JovanyZepeda/Baja-CPP-Power-Module/LT3579-SEPIC-EAGLE-Project/Custom or imported Eagle Libraries/SDT5H100SB-13.stp

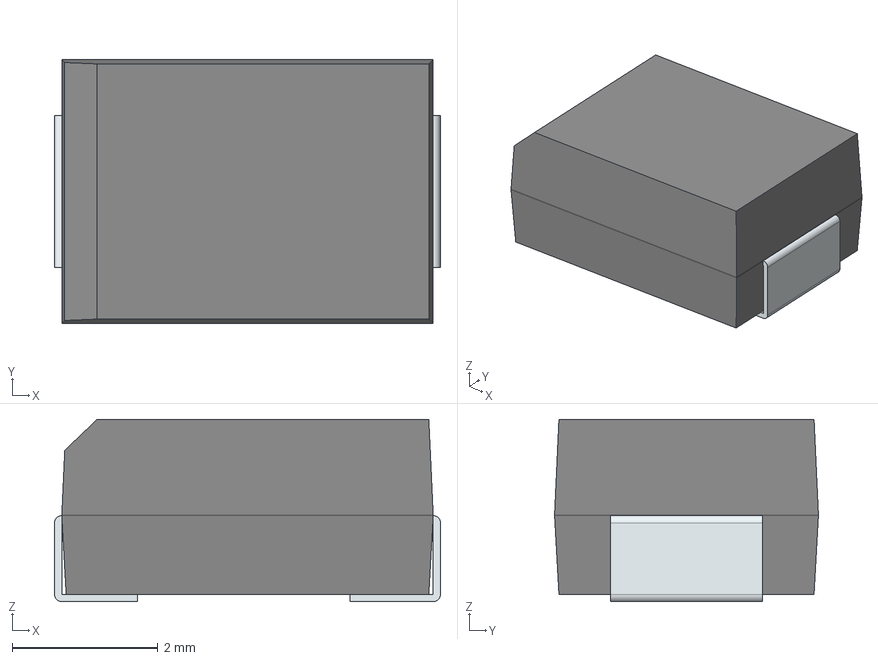
[picture p1: CAD file, 2022-03-18]
LT3579-SEPIC-EAGLE-Project/Custom or imported Eagle Libraries/SDT5H100SB-13.stp
5.29 x 3.62 x 2.50 mm
FilletPin1
FilletPin2
