JovanyZepeda/Baja-CPP-Power-Module/(list of files, cad)

Other CAD files:
LT3579-SEPIC-EAGLE-Project/Custom or imported Eagle Libraries/SDT5H100SB-13.stl
