JovanyZepeda/Baja-CPP-Power-Module/LT3579-SEPIC-EAGLE-Project/LT3579_SEPIC_Test_Bench.pdf

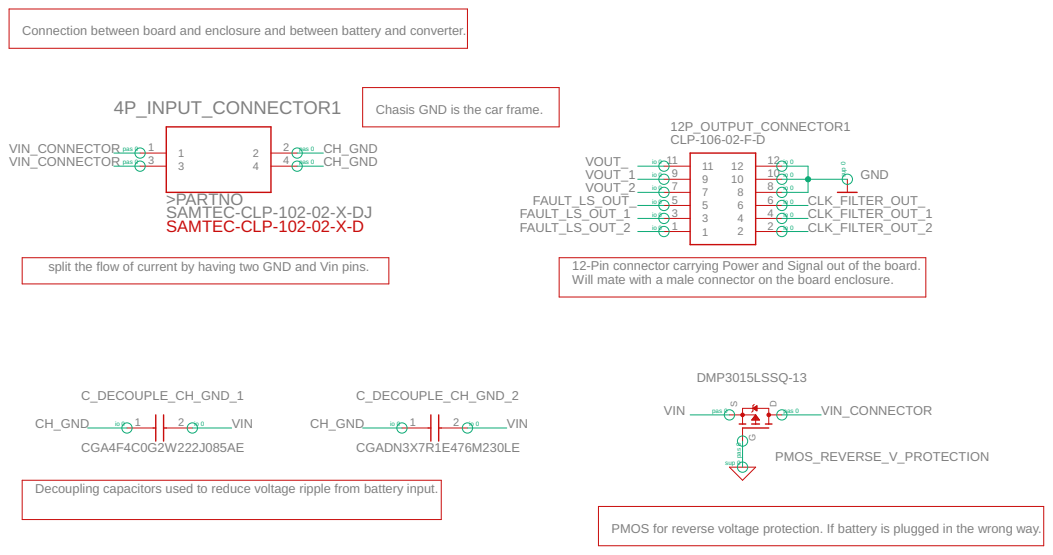
[picture p2: page 1]

Connection between board and enclosure and between battery and converter.

Chasis GND is the car frame.

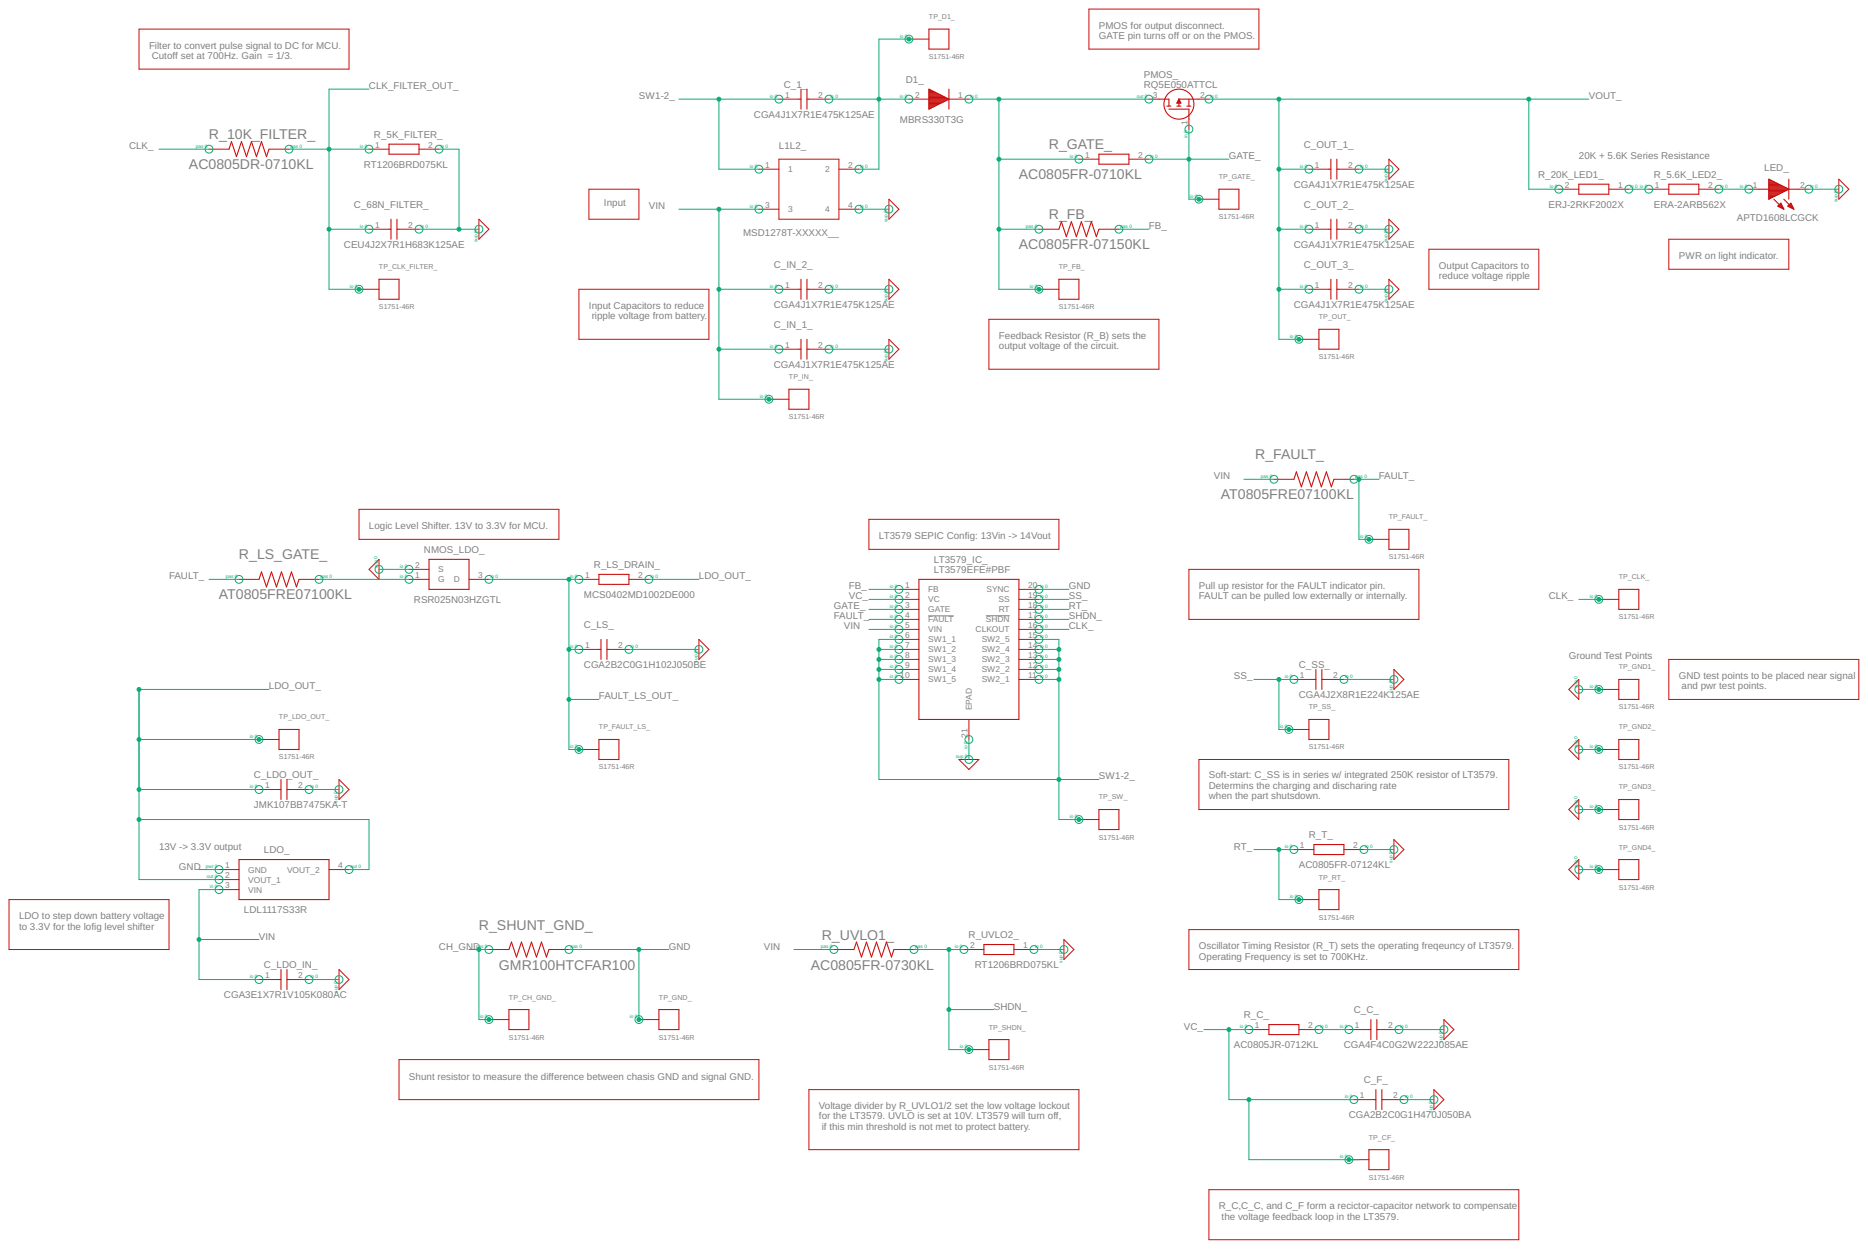
[picture p3: page 2]

PMOS for output disconnect. GATE pin turns off or on the PMOS.

Filter to convert pulse signal to DC for MCU. Cutoff set at 700Hz. Gain = 1/3.

PWR on light indicator.

Input Capacitors to reduce

Feedback Resistor (R_B) sets the
output voltage of the circuit.

Logic Level Shifter. 13V to 3.3V for MCU.

Pull up resistor for the FAULT indicator pin. FAULT can be pulled low externally or internally.

up 0 sup 0 sup 0 sup 0

GND test points to be placed near signal and pwr test points.

Soft-start: C_SS is in series w/ integrated 250K resistor of LT3579. Determins the charging and discharing rate when the part shutsdown.

LDO to step down battery voltage
to 3.3V for the lofig level shifter

Oscillator Timing Resistor (R_T) sets the operating freqeuncy of LT3579. Operating Frequency is set to 700KHz.

Shunt resistor to measure the difference between chasis GND and signal GND.

Voltage divider by R_UVLO1/2 set the low voltage lockout
for the LT3579. UVLO is set at 10V. LT3579 will turn off,
if this min threshold is not met to protect battery.

R_C,C_C, and C_F form a recictor-capacitor network to compensate
the voltage feedback loop in the LT3579.

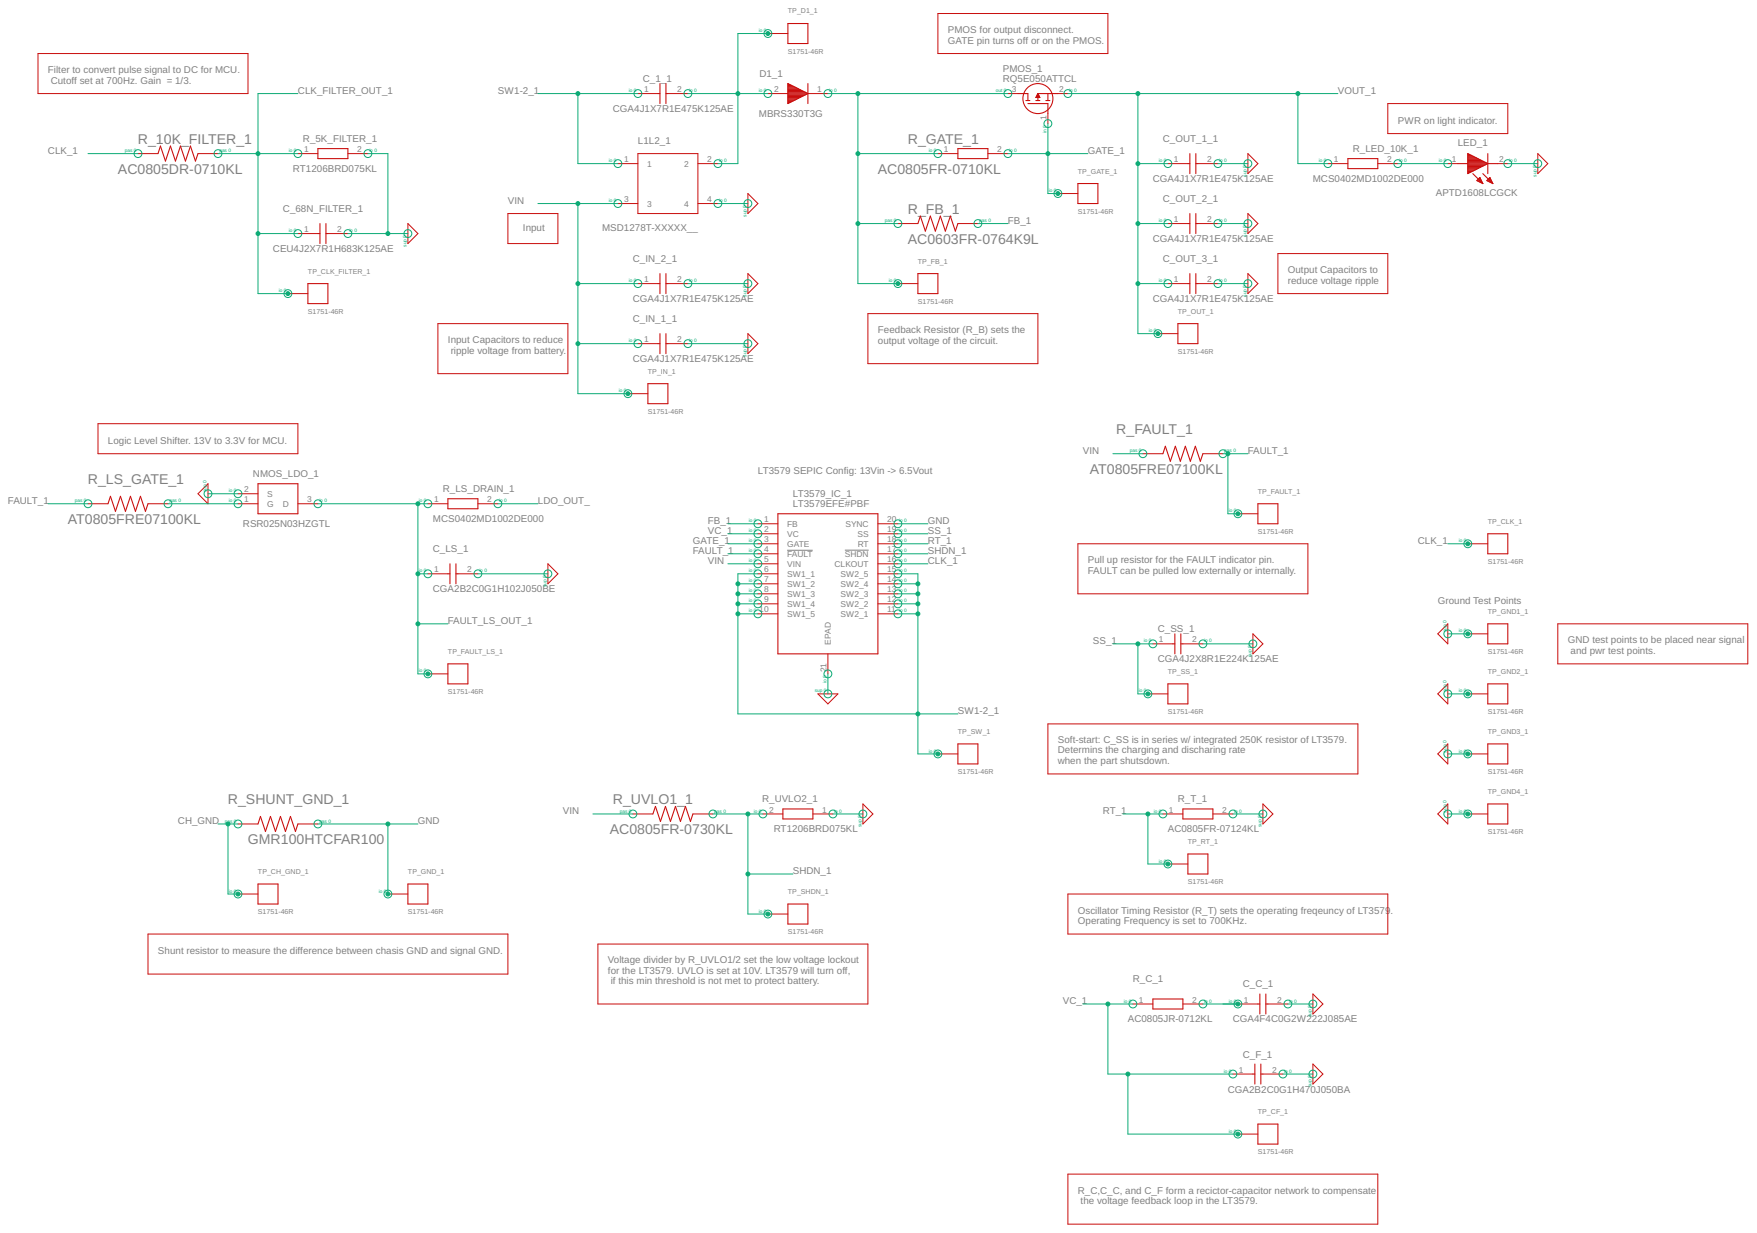
[picture p4: page 3]

Filter to convert pulse signal to DC for MCU. Cutoff set at 700Hz. Gain = 1/3.

PWR on light indicator.

reduce voltage ripple Feedback Resistor (R_B) sets the

Input Capacitors to reduce
ripple voltage from battery.

output voltage of the circuit.

Logic Level Shifter. 13V to 3.3V for MCU.

Pull up resistor for the FAULT indicator pin. FAULT can be pulled low externally or internally.

up 0 sup 0 sup 0 sup 0

GND test points to be placed near signal and pwr test points.

Soft-start: C_SS is in series w/ integrated 250K resistor of LT3579. Determins the charging and discharing rate when the part shutsdown.

Oscillator Timing Resistor (R_T) sets the operating freqeuncy of LT3579. Operating Frequency is set to 700KHz.

Shunt resistor to measure the difference between chasis GND and signal GND.

Voltage divider by R_UVLO1/2 set the low voltage lockout
for the LT3579. UVLO is set at 10V. LT3579 will turn off,
if this min threshold is not met to protect battery.

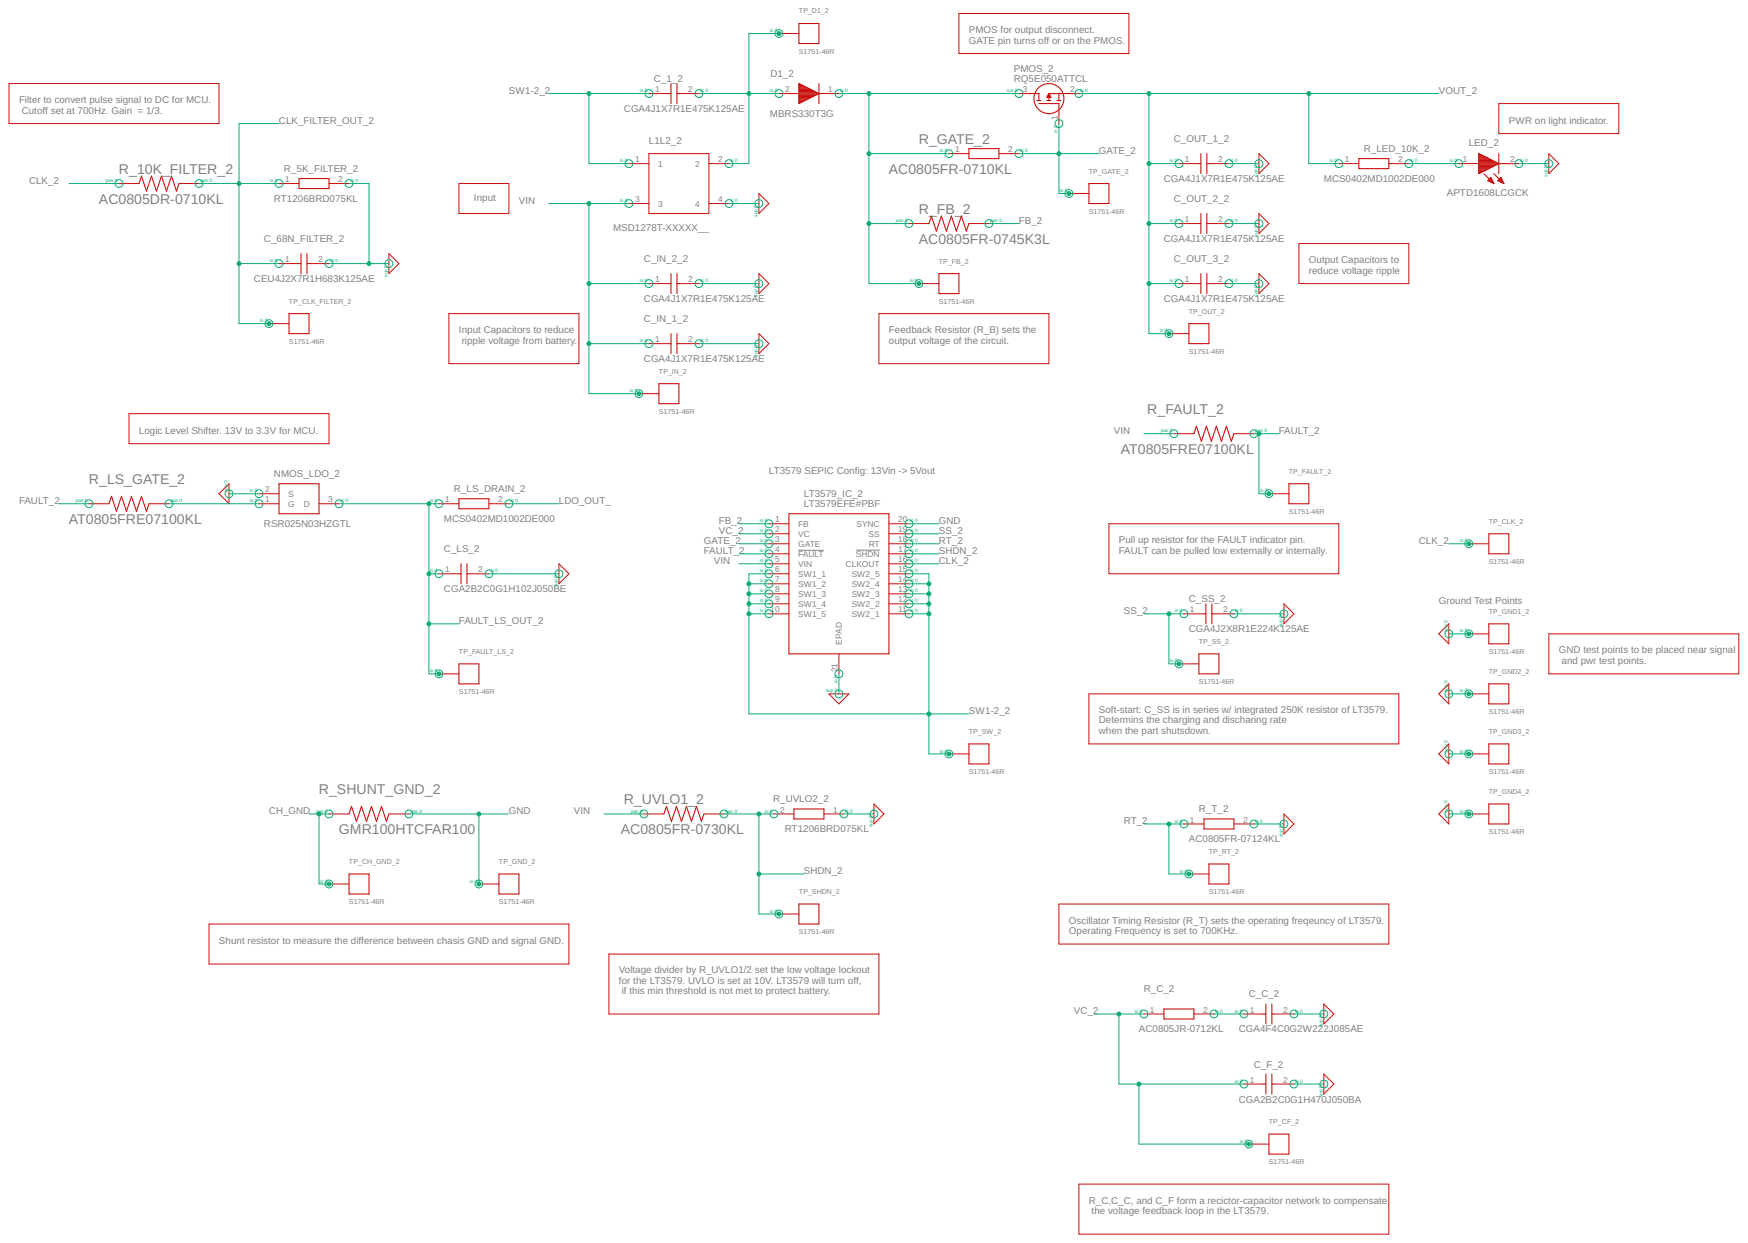
[picture p5: page 4]

Filter to convert pulse signal to DC for MCU. Cutoff set at 700Hz. Gain = 1/3.

PWR on light indicator.

reduce voltage ripple Feedback Resistor (R_B) sets the

Input Capacitors to reduce
ripple voltage from battery.

output voltage of the circuit.

Logic Level Shifter. 13V to 3.3V for MCU.

Pull up resistor for the FAULT indicator pin. FAULT can be pulled low externally or internally.

up 0 sup 0 sup 0 sup 0

GND test points to be placed near signal and pwr test points.

Soft-start: C_SS is in series w/ integrated 250K resistor of LT3579. Determins the charging and discharing rate when the part shutsdown.

Oscillator Timing Resistor (R_T) sets the operating freqeuncy of LT3579. Operating Frequency is set to 700KHz.

Shunt resistor to measure the difference between chasis GND and signal GND.

Voltage divider by R_UVLO1/2 set the low voltage lockout
for the LT3579. UVLO is set at 10V. LT3579 will turn off,
if this min threshold is not met to protect battery.
