JovanyZepeda/Baja-CPP-Power-Module/LT3579-SEPIC-13Vin_14Vout/LT3579_SEPIC_0009.asc

C1: cap; 4.7µ; V=35 Rser=0.001
C_c: cap; 2.2n; V=50
C_F: cap; 47p; V=25
C_IN: cap; 4.7µ; x2; V=35 Irms=0 Rser=0.001 Lser=0
C_OUT: cap; 4.7µ; x3; V=35 Irms=0 Rser=0.001 Lser=0
C_SS: cap; 0.02µ; V=50
D1: schottky
D2: schottky
L1: ind2; 8.2µ; Ipk=10 Rser=55m
L2: ind2; 8.2µ; Ipk=10 Rser=55m
M1: pmos
R1: res; 6.5k
R_c: res; 7.5k; tol=1
R_FAULT: res; 100k; tol=1
R_FB: res; 153k; tol=1
R_LOAD: res; 14
R_T: res; 124k; tol=1
R_UVLO1: res; 13k; tol=1
R_UVLO2: res; 5k; tol=0.1
U1: LT3579
V_Battery: voltage; 13
Named nets: 0, IN, OUT, SS, Vc, SW1/2, FT, SHDN, GATE, FB, DRAIN
K1 L1 L2 1
.tran 0 2ms 0 0.001 startup
Note: C_SS is actually 0.22u  but has been changed to 0.022u  so that the rise time is smaller. Increases speed of simulation.
13V
0A
700 khz
Compensator Circuit
.step param R_LOAD 1 30 1
