JovanyZepeda/Baja-CPP-Power-Module/LT3579-CLK-Filter/LT3579_SEPIC_CLK_Filter_01.asc

C1: cap; 68.2n
R1: res; 10k
R2: res; 5k
V1: voltage; PULSE(0 3 0 12n 8n {t_ON} 1.428u)
Named nets: 0
.tran 0 10m 0 0.01
.step param t_ON 0.28571u 0.999u 0.05u
Test filter from MATLAB code. Filter out the higher harmonics of pulse and keep the DC componant for MCU to read.
F_c = 700 Hz, Gain = 1/3
