JovanyZepeda/Baja-CPP-Power-Module/LT3579-SEPIC-13Vin_5Vout/LT3579_SEPIC_13Vin_5Vout_01.asc

C1: cap; 4.7µ; V=25 Rser=0.01
C_c: cap; 2.2n; V=450
C_F: cap; 47p; V=50
C_IN: cap; 4.7; x2; V=25 Irms=0 Rser=0.01 Lser=0
C_OUT: cap; 4.7µ; x3; V=25 Irms=0 Rser=0.01 Lser=0 Rpar=0
C_SS: cap; 0.022µ; V=25
D1: schottky; MBRS360
L1: ind2; 8.2µ; Ipk=10 Rser=55m
L2: ind2; 8.2µ; Ipk=10 Rser=55m
R_c: res; 12k; tol=5
R_FAULT: res; 100k; tol=1
R_FB: res; 45.3k; tol=1
R_GATE: res; 10k
R_LOAD: res; 5
R_T: res; 124k; tol=5
R_UVLO1: res; 30k; tol=1
R_UVLO2: res; 5k; tol=0.1
U1: LT3579
U2: RQ5E050AT
V_Battery: voltage; 13; Rser=0.4
Named nets: 0, IN, SOURCE, SS, Vc, SW1/2, FT, SHDN, GATE, FB, DRAIN, Vbattery
K1 L1 L2 0.98
Note: C_SS is actually 0.22u  but has been changed to 0.022u  so that the rise time is smaller. Increases speed of simulation.
0A
700 khz
Compensator Circuit
100k Potentiometer = R_c for testing board
.tran 0 2ms 0
MSD1278T Coupling Coefficient = 0.98
13Vin -> 5Vout SEPIC
