JovanyZepeda/Baja-CPP-Power-Module/LT3579-SEPIC-13Vin_14Vout/LT3579_SEPIC_MC1.asc

C1: cap; {mc(4.7u,0.1)}; V=25 Rser=0.01
C_c: cap; {mc(2.2n,0.5)}; V=450
C_F: cap; {mc(47p,0.05)}; V=50
C_IN: cap; {mc(4.7u,0.1)}; x2; V=25 Irms=0 Rser=0.01 Lser=0
C_OUT: cap; {mc(4.7u,0.1)}; x3; V=25 Irms=0 Rser=0.01 Lser=0 Rpar=0
C_SS: cap; 0.022µ; V=25
D1: schottky; MBRS360
L1: ind2; {mc(8.2u,0.2)}; Ipk=10 Rser=55m
L2: ind2; {mc(8.2u,0.2)}; Ipk=10 Rser=55m
R_c: res; {mc(12k,0.5)}; tol=5
R_FAULT: res; {mc(100k,0.01)}; tol=1
R_FB: res; {mc(150k,0.01)}; tol=1
R_GATE: res; {mc(10k,0.005)}
R_LOAD: res; {mc(18,0.2)}
R_T: res; {mc(124k,0.05)}; tol=5
R_UVLO1: res; {mc(30k,0.01)}; tol=1
R_UVLO2: res; {mc(5k,0.01)}; tol=0.1
U1: LT3579
U2: RQ5E050AT
V_Battery: voltage; {mc(13,0.25)}; Rser=0.4
Named nets: 0, IN, SOURCE, SS, Vc, SW1/2, FT, SHDN, GATE, FB, DRAIN
K1 L1 L2 0.98
Note: C_SS is actually 0.22u  but has been changed to 0.022u  so that the rise time is smaller. Increases speed of simulation.
0A
700 khz
Compensator Circuit
100k Potentiometer = R_c for testing board
.tran 0 2ms 1.8ms startup
MSD1278T Coupling Coefficient = 0.98
Monte Carlo Simulation Test
.step param X 1 100 1
Monte carlo sim is set so that 100 trials are run, each for 2ms.
w/ Varying Input Voltage
