JovanyZepeda/Baja-CPP-Power-Module/LT3579-SEPIC-13Vin_14Vout/LT3579_SEPIC_0003.asc

C1: cap; 4.7µ
C_c: cap; 2.2n
C_F: cap; 47p
C_IN: cap; 4.7
C_OUT: cap; 10µ; V=25 Irms=0 Rser=0.001 Lser=0
C_SS: cap; 0.022µ
D1: schottky; PDS5100
L1: ind2; 8.2µ
L2: ind2; 8.2µ
R_c: res; 10k
R_FAULT: res; 100k
R_FB: res; 153k
R_LOAD: res; 14
R_T: res; 124k
R_UVLO1: res; 13k
R_UVLO2: res; 5k
U1: LT3579
V_Battery: voltage; 13
Named nets: 0, IN, OUT, SS, Vc, SW1/2, FT, SHDN
K1 L1 L2 1
.tran 0 2m 1m startup
Note: C_SS is actually 0.22u  but has been changed to 0.022u  so that the rise time is smaller. Increases speed of simulation.
Cout: Three parallel capacitors 
for a total capacitance of 27.41u
