JovanyZepeda/Baja-CPP-Power-Module/LT3579-SEPIC-13Vin_14Vout/LT3579_SEPIC_0001.asc

C1: cap; 4.7µ
C_c: cap; 2.2n
C_F: cap; 47p
C_IN: cap; 5.08µ
C_OUT_1: cap; 27.41µ
C_OUT_2: cap; 27.41µ
C_OUT_3: cap; 27.41µ
C_SS: cap; 1n
D1: schottky
L1: ind2; 8µ
L2: ind2; 8µ
R_c: res; 10k
R_FAULT: res; 100k
R_FB: res; 153.48k
R_LOAD: res; 14
R_T: res; 124.14
R_UVLO1: res; 13.22k
R_UVLO2: res; 5k
U1: LT3579
V_Battery: voltage; 13
Named nets: 0, IN, OUT, SS, SHDN, Vc, SW1/2, FT
K L1 L2 1
.tran  2m  startup
Note: C_SS is actually 100n but has been changed to 1n so that the rise time is smaller. Increases speed of simulation.
