JovanyZepeda/Baja-CPP-Power-Module/LT3579-SEPIC-EAGLE-Project/LT3579_SEPIC_Test_Bench.brd

## EAGLE design LT3579-SEPIC-EAGLE-Project/LT3579_SEPIC_Test_Bench.brd (2022-04-27)

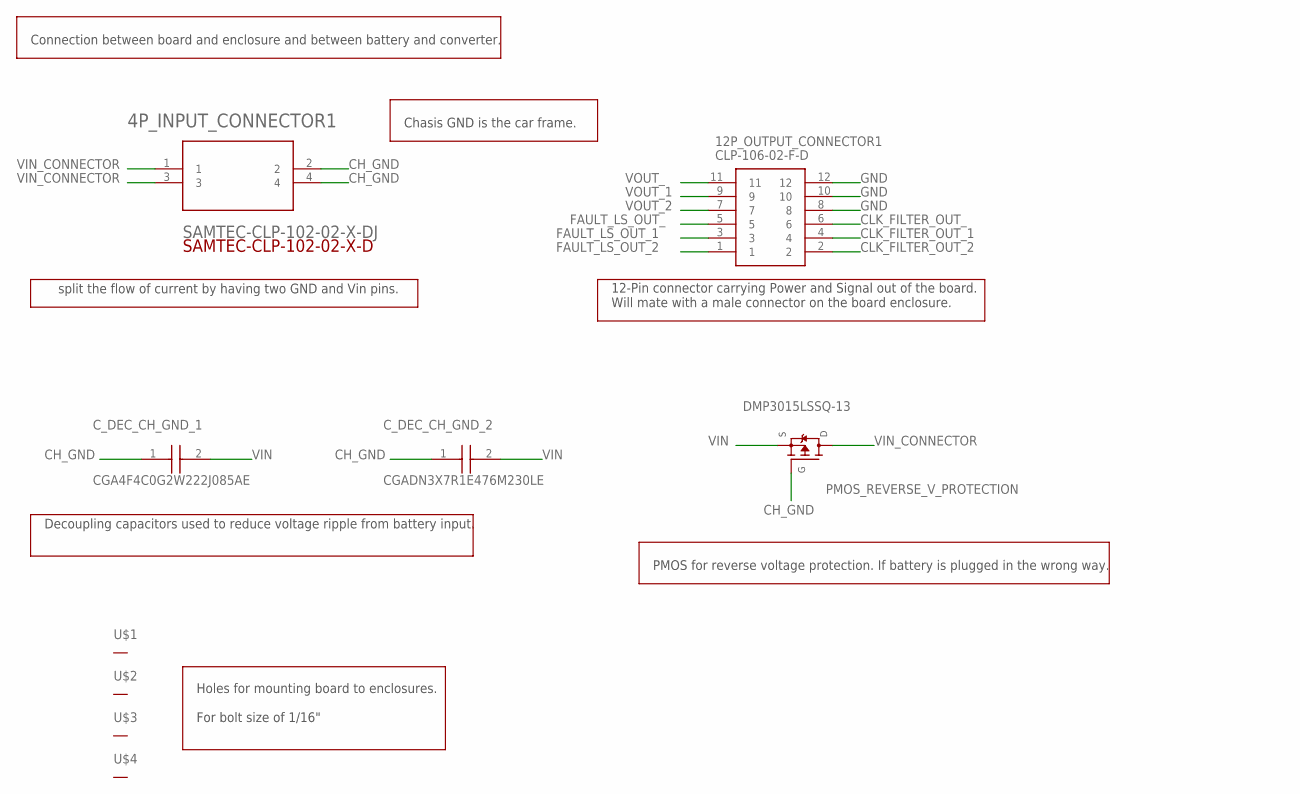
[picture p6: schematic LT3579_SEPIC_Test_Bench.sch, sheet 1]

Parts:
4P_INPUT_CONNECTOR1: SAMTEC-CLP-102-02-X-DJ; SAMTEC-CLP-102-02-X-D
12P_OUTPUT_CONNECTOR1: CLP-106-02-F-D; CLP-106-02-XXX
C_DEC_CH_GND_1: CGA4F4C0G2W222J085AE; CAPC2012X100N
C_DEC_CH_GND_2: CGADN3X7R1E476M230LE; CAPC7563X250N
PMOS_REVERSE_V_PROTECTION: DMP3015LSSQ-13; SOIC127P600X170-8N
U$1, U$2, U$3, U$4: THROUGH_HOLE_; THROUGH_HOLE

Connections:
CH_GND: 4P_INPUT_CONNECTOR1.2, 4P_INPUT_CONNECTOR1.4, C_DEC_CH_GND_1.1, C_DEC_CH_GND_2.1, PMOS_REVERSE_V_PROTECTION.4 (G1); also elsewhere on the board
CLK_FILTER_OUT_: 12P_OUTPUT_CONNECTOR1.6; also elsewhere on the board
CLK_FILTER_OUT_1: 12P_OUTPUT_CONNECTOR1.4; also elsewhere on the board
CLK_FILTER_OUT_2: 12P_OUTPUT_CONNECTOR1.2; also elsewhere on the board
FAULT_LS_OUT_: 12P_OUTPUT_CONNECTOR1.5; also elsewhere on the board
FAULT_LS_OUT_1: 12P_OUTPUT_CONNECTOR1.3; also elsewhere on the board
FAULT_LS_OUT_2: 12P_OUTPUT_CONNECTOR1.1; also elsewhere on the board
GND: 12P_OUTPUT_CONNECTOR1.8, 12P_OUTPUT_CONNECTOR1.10, 12P_OUTPUT_CONNECTOR1.12; also elsewhere on the board
VIN: C_DEC_CH_GND_1.2, C_DEC_CH_GND_2.2, PMOS_REVERSE_V_PROTECTION.1 (S1), PMOS_REVERSE_V_PROTECTION.2 (S1), PMOS_REVERSE_V_PROTECTION.3 (S1); also elsewhere on the board
VIN_CONNECTOR: 4P_INPUT_CONNECTOR1.1, 4P_INPUT_CONNECTOR1.3, PMOS_REVERSE_V_PROTECTION.5 (D1), PMOS_REVERSE_V_PROTECTION.6 (D1), PMOS_REVERSE_V_PROTECTION.7 (D1), PMOS_REVERSE_V_PROTECTION.8 (D1)
VOUT_: 12P_OUTPUT_CONNECTOR1.11; also elsewhere on the board
VOUT_1: 12P_OUTPUT_CONNECTOR1.9; also elsewhere on the board
VOUT_2: 12P_OUTPUT_CONNECTOR1.7; also elsewhere on the board

Notes on the sheet:
Connection between board and enclosure and between battery and converter.
split the flow of current by having two GND and Vin pins.
12-Pin connector carrying Power and Signal out of the board. Will mate with a male connector on the board enclosure.
Decoupling capacitors used to reduce voltage ripple from battery input.
PMOS for reverse voltage protection. If battery is plugged in the wrong way.
Chasis GND is the car frame.
Holes for mounting board to enclosures. For bolt size of 1/16"

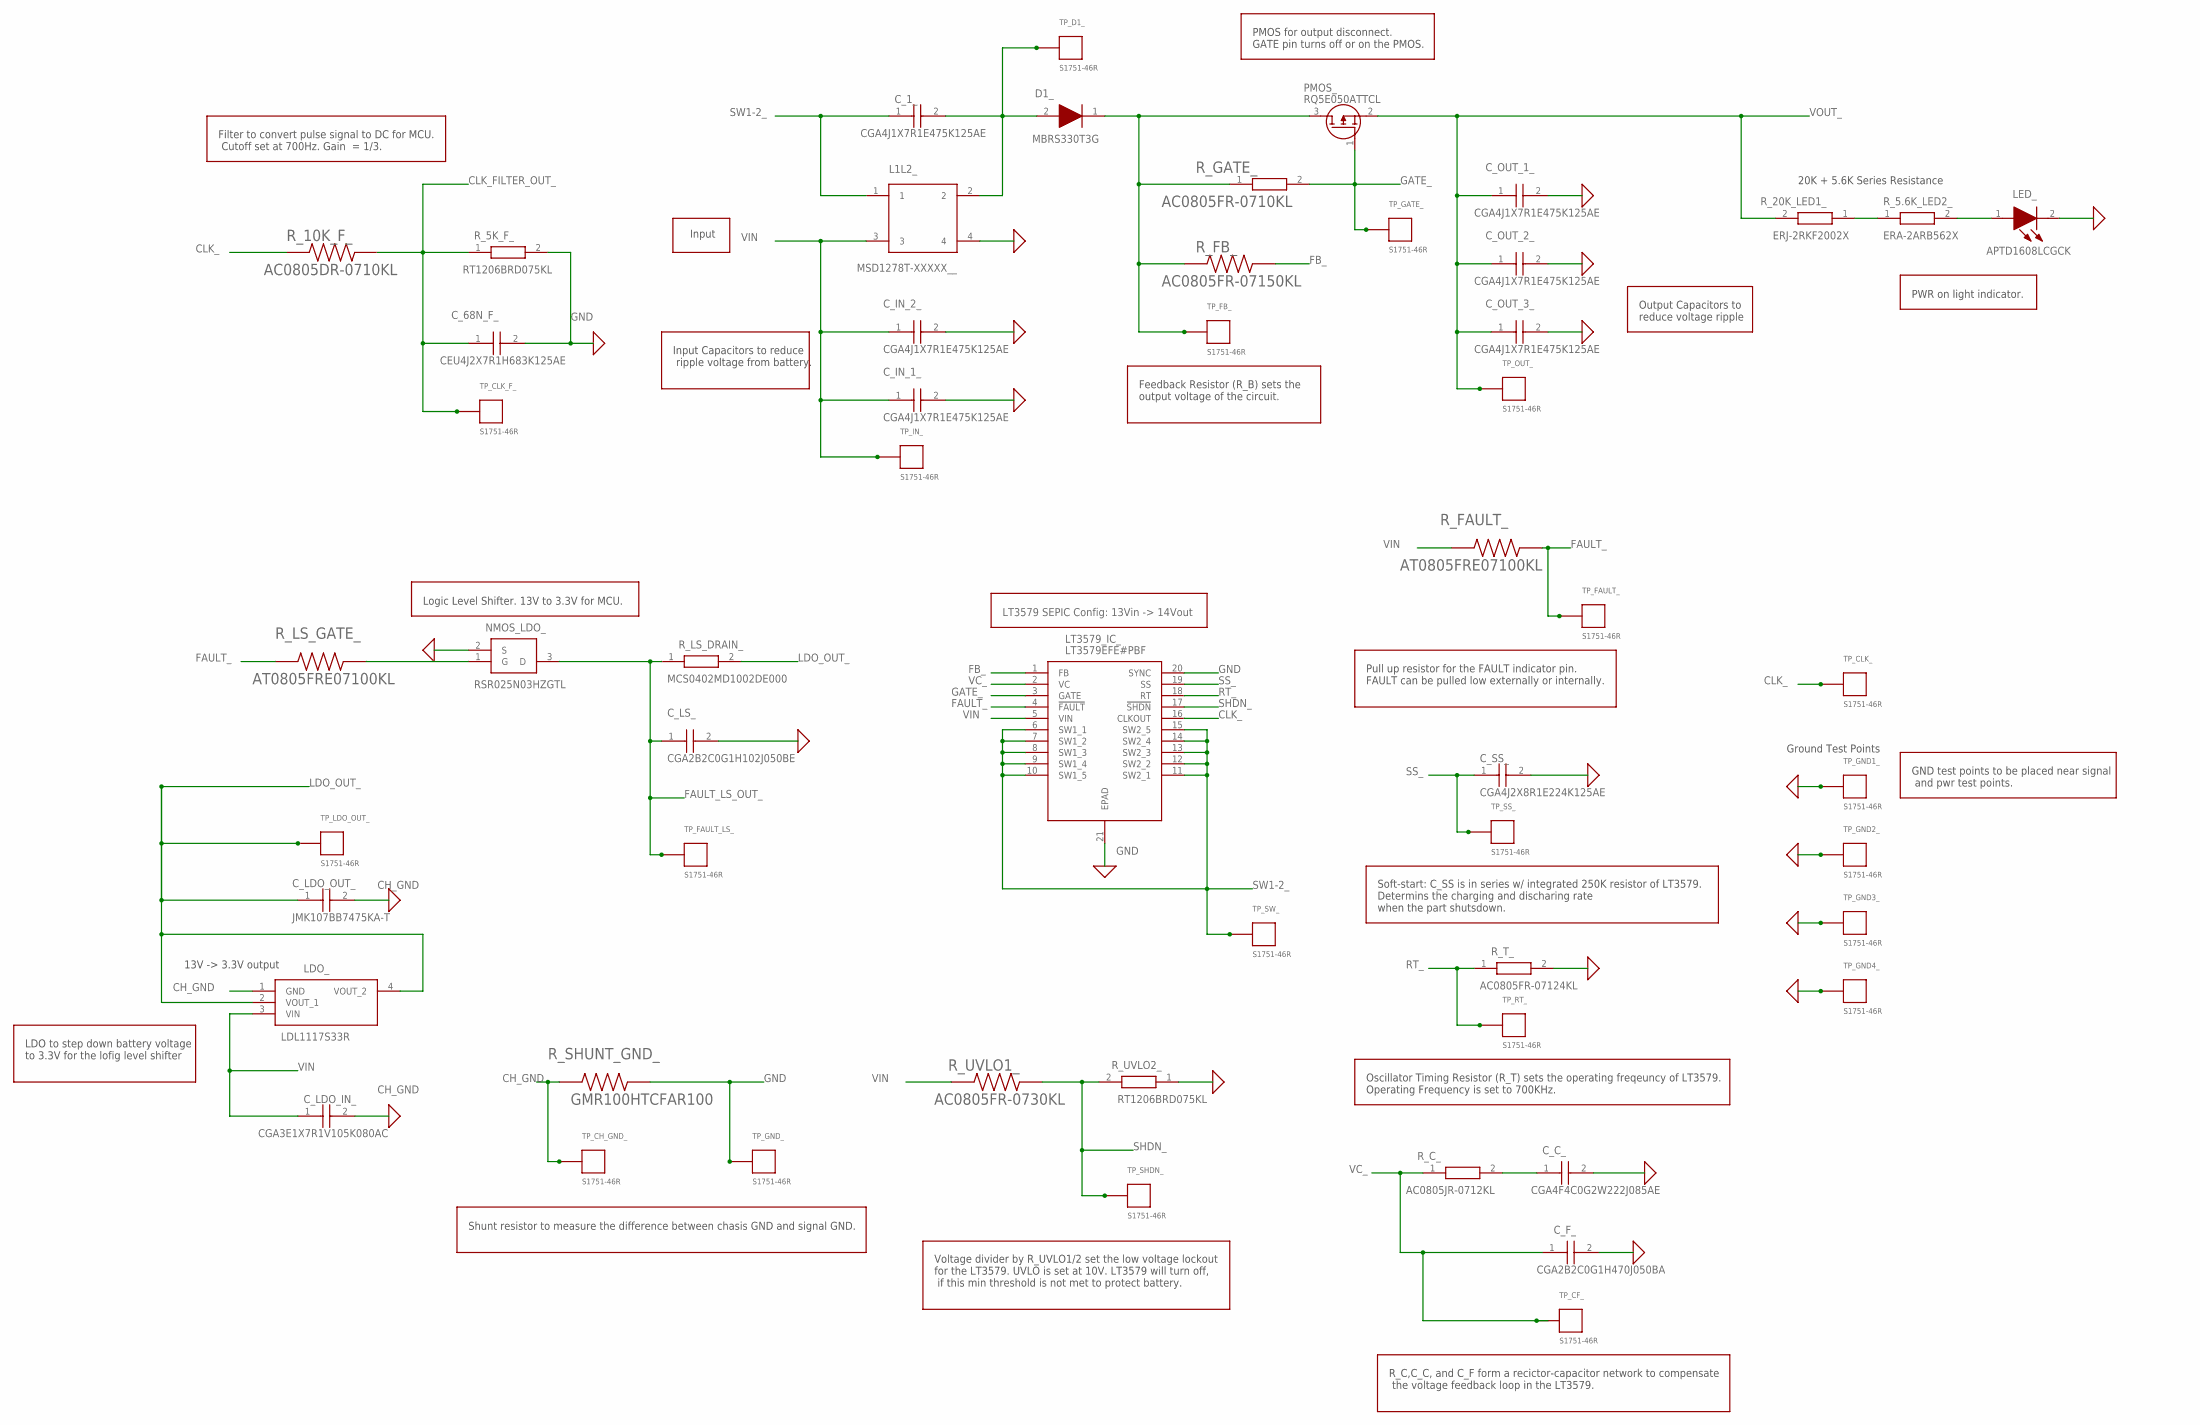
[picture p7: schematic LT3579_SEPIC_Test_Bench.sch, sheet 2]

Parts:
C_1_: CGA4J1X7R1E475K125AE; CAPC2012X145N
C_68N_F_: CEU4J2X7R1H683K125AE; CAPC2013X150N
C_C_: CGA4F4C0G2W222J085AE; CAPC2012X100N
C_F_: CGA2B2C0G1H470J050BA; CAPC1005X55N
C_IN_1_, C_IN_2_: CGA4J1X7R1E475K125AE; CAPC2012X145N
C_LDO_IN_: CGA3E1X7R1V105K080AC; CAPC1608X90N
C_LDO_OUT_: JMK107BB7475KA-T; CAPC1608X90N
C_LS_: CGA2B2C0G1H102J050BE; CAPC1005X55N
C_OUT_1_, C_OUT_2_, C_OUT_3_: CGA4J1X7R1E475K125AE; CAPC2012X145N
C_SS_: CGA4J2X8R1E224K125AE; CAPC2012X145N
D1_: MBRS330T3G; DIOM7958X256N
L1L2_: MSD1278T-XXXXX__; MSD1278T-822MLXX
LDO_: LDL1117S33R; SOT230P700X180-4N
LED_: APTD1608LCGCK; APT1608CGCK
LT3579_IC_: LT3579EFE#PBF; SOP65P640X120-21N
NMOS_LDO_: RSR025N03HZGTL; SOT95P280X100-3N
PMOS_: RQ5E050ATTCL; SOT95P280X100-3N
R_5.6K_LED2_: ERA-2ARB562X; ERA2AED122X
R_5K_F_: RT1206BRD075KL; RESC3116X65N
R_10K_F_: AC0805DR-0710KL; RESC2012X60N
R_20K_LED1_: ERJ-2RKF2002X; ERJ2R_(0402)
R_C_: AC0805JR-0712KL; RESC2012X60N
R_FAULT_: AT0805FRE07100KL; RESC2012X60N
R_FB_: AC0805FR-07150KL; RESC2012X60N
R_GATE_: AC0805FR-0710KL; RESC2012X60N
R_LS_DRAIN_: MCS0402MD1002DE000; RESC1005X37N
R_LS_GATE_: AT0805FRE07100KL; RESC2012X60N
R_SHUNT_GND_: GMR100HTCFAR100; RESC6432X55N
R_T_: AC0805FR-07124KL; RESC2012X60N
R_UVLO1_: AC0805FR-0730KL; RESC2012X60N
R_UVLO2_: RT1206BRD075KL; RESC3116X65N
TP_CF_: S1751-46R; S1751-46R_
TP_CH_GND_: S1751-46R; S1751-46R_
TP_CLK_: S1751-46R; S1751-46R_
TP_CLK_F_: S1751-46R; S1751-46R_
TP_D1_: S1751-46R; S1751-46R_
TP_FAULT_: S1751-46R; S1751-46R_
TP_FAULT_LS_: S1751-46R; S1751-46R_
TP_FB_: S1751-46R; S1751-46R_
TP_GATE_: S1751-46R; S1751-46R_
TP_GND1_, TP_GND2_, TP_GND3_, TP_GND4_: S1751-46R; S1751-46R_
TP_GND_: S1751-46R; S1751-46R_
TP_IN_: S1751-46R; S1751-46R_
TP_LDO_OUT_: S1751-46R; S1751-46R_
TP_OUT_: S1751-46R; S1751-46R_
TP_RT_: S1751-46R; S1751-46R_
TP_SHDN_: S1751-46R; S1751-46R_
TP_SS_: S1751-46R; S1751-46R_
TP_SW_: S1751-46R; S1751-46R_

Connections:
CH_GND: C_LDO_IN_.2, C_LDO_OUT_.2, LDO_.1 (GND), R_SHUNT_GND_.1, TP_CH_GND_.1; also elsewhere on the board
CLK_: LT3579_IC_.16 (CLKOUT), R_10K_F_.1, TP_CLK_.1
CLK_FILTER_OUT_: C_68N_F_.1, R_5K_F_.1, R_10K_F_.2, TP_CLK_F_.1; also elsewhere on the board
FAULT_: LT3579_IC_.4 (!FAULT), R_FAULT_.1, R_LS_GATE_.1, TP_FAULT_.1
FAULT_LS_OUT_: C_LS_.1, NMOS_LDO_.3 (D), R_LS_DRAIN_.1, TP_FAULT_LS_.1; also elsewhere on the board
FB_: LT3579_IC_.1 (FB), R_FB_.2
GATE_: LT3579_IC_.3 (GATE), PMOS_.1 (G), R_GATE_.2, TP_GATE_.1
GND: C_68N_F_.2, C_C_.2, C_F_.2, C_IN_1_.2, C_IN_2_.2, C_LS_.2, C_OUT_1_.2, C_OUT_2_.2, C_OUT_3_.2, C_SS_.2, L1L2_.4, LED_.2 (K), LT3579_IC_.20 (SYNC), LT3579_IC_.21 (EPAD), NMOS_LDO_.2 (S), R_5K_F_.2, R_SHUNT_GND_.2, R_T_.2, R_UVLO2_.1, TP_GND1_.1, TP_GND2_.1, TP_GND3_.1, TP_GND4_.1, TP_GND_.1; also elsewhere on the board
LDO_OUT_: C_LDO_OUT_.1, LDO_.2 (VOUT_1), LDO_.4 (VOUT_2), R_LS_DRAIN_.2, TP_LDO_OUT_.1; also elsewhere on the board
unnamed: C_C_.1, R_C_.2
unnamed: NMOS_LDO_.1 (G), R_LS_GATE_.2
unnamed: C_1_.2, D1_.2 (A), L1L2_.2, TP_D1_.1
unnamed: R_5.6K_LED2_.1, R_20K_LED1_.1
unnamed: D1_.1 (K), PMOS_.3 (D), R_FB_.1, R_GATE_.1, TP_FB_.1
unnamed: LED_.1 (A), R_5.6K_LED2_.2
RT_: LT3579_IC_.18 (RT), R_T_.1, TP_RT_.1
SHDN_: LT3579_IC_.17 (!SHDN), R_UVLO1_.1, R_UVLO2_.2, TP_SHDN_.1
SS_: C_SS_.1, LT3579_IC_.19 (SS), TP_SS_.1
SW1-2_: C_1_.1, L1L2_.1, LT3579_IC_.6 (SW1_1), LT3579_IC_.7 (SW1_2), LT3579_IC_.8 (SW1_3), LT3579_IC_.9 (SW1_4), LT3579_IC_.10 (SW1_5), LT3579_IC_.11 (SW2_1), LT3579_IC_.12 (SW2_2), LT3579_IC_.13 (SW2_3), LT3579_IC_.14 (SW2_4), LT3579_IC_.15 (SW2_5), TP_SW_.1
VC_: C_F_.1, LT3579_IC_.2 (VC), R_C_.1, TP_CF_.1
VIN: C_IN_1_.1, C_IN_2_.1, C_LDO_IN_.1, L1L2_.3, LDO_.3 (VIN), LT3579_IC_.5 (VIN), R_FAULT_.2, R_UVLO1_.2, TP_IN_.1; also elsewhere on the board
VOUT_: C_OUT_1_.1, C_OUT_2_.1, C_OUT_3_.1, PMOS_.2 (S), R_20K_LED1_.2, TP_OUT_.1; also elsewhere on the board

Notes on the sheet:
LT3579 SEPIC Config: 13Vin -> 14Vout
Ground Test Points
Filter to convert pulse signal to DC for MCU. Cutoff set at 700Hz. Gain = 1/3.
13V -> 3.3V output
Logic Level Shifter. 13V to 3.3V for MCU.
20K + 5.6K Series Resistance
PWR on light indicator.
Voltage divider by R_UVLO1/2 set the low voltage lockout for the LT3579. UVLO is set at 10V. LT3579 will turn off, if this min threshold is not met to protect battery.
Oscillator Timing Resistor (R_T) sets the operating freqeuncy of LT3579. Operating Frequency is set to 700KHz.
R_C,C_C, and C_F form a recictor-capacitor network to compensate the voltage feedback loop in the LT3579.
Soft-start: C_SS is in series w/ integrated 250K resistor of LT3579. Determins the charging and discharing rate when the part shutsdown.
Pull up resistor for the FAULT indicator pin. FAULT can be pulled low externally or internally.
Shunt resistor to measure the difference between chasis GND and signal GND.
LDO to step down battery voltage to 3.3V for the lofig level shifter
GND test points to be placed near signal and pwr test points.
Input Capacitors to reduce ripple voltage from battery.
Output Capacitors to reduce voltage ripple
PMOS for output disconnect. GATE pin turns off or on the PMOS.
Feedback Resistor (R_B) sets the output voltage of the circuit.
Input

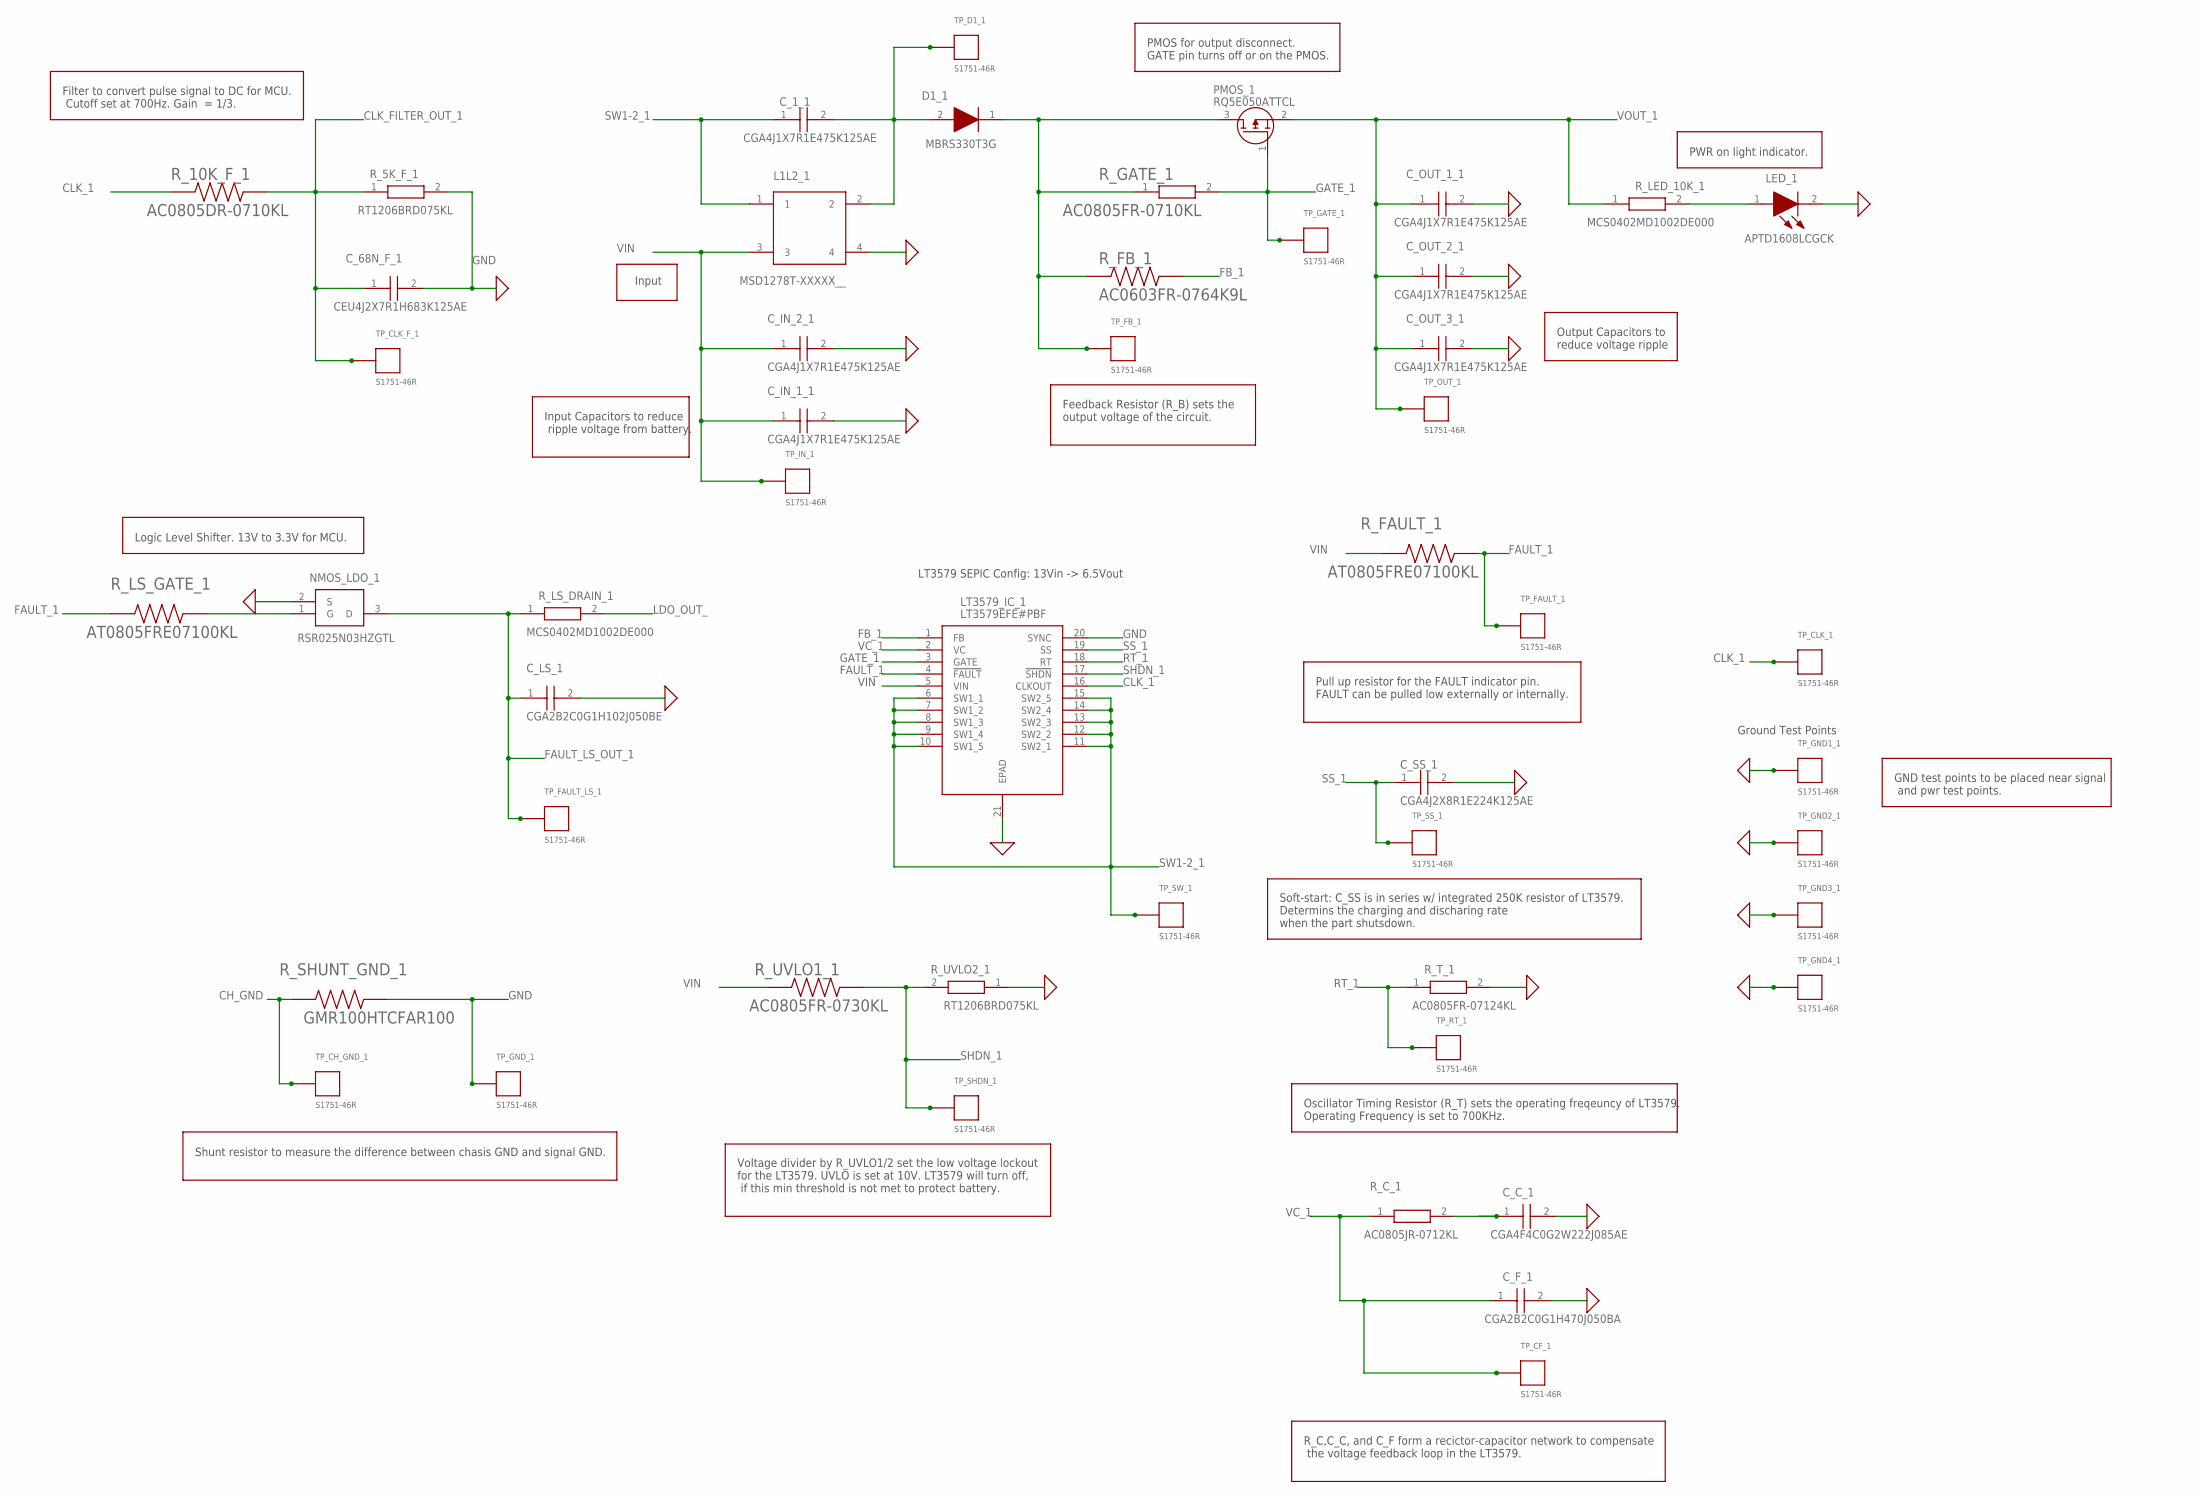
[picture p8: schematic LT3579_SEPIC_Test_Bench.sch, sheet 3]

Parts:
C_1_1: CGA4J1X7R1E475K125AE; CAPC2012X145N
C_68N_F_1: CEU4J2X7R1H683K125AE; CAPC2013X150N
C_C_1: CGA4F4C0G2W222J085AE; CAPC2012X100N
C_F_1: CGA2B2C0G1H470J050BA; CAPC1005X55N
C_IN_1_1, C_IN_2_1: CGA4J1X7R1E475K125AE; CAPC2012X145N
C_LS_1: CGA2B2C0G1H102J050BE; CAPC1005X55N
C_OUT_1_1, C_OUT_2_1, C_OUT_3_1: CGA4J1X7R1E475K125AE; CAPC2012X145N
C_SS_1: CGA4J2X8R1E224K125AE; CAPC2012X145N
D1_1: MBRS330T3G; DIOM7958X256N
L1L2_1: MSD1278T-XXXXX__; MSD1278T-822MLXX
LED_1: APTD1608LCGCK; APT1608CGCK
LT3579_IC_1: LT3579EFE#PBF; SOP65P640X120-21N
NMOS_LDO_1: RSR025N03HZGTL; SOT95P280X100-3N
PMOS_1: RQ5E050ATTCL; SOT95P280X100-3N
R_5K_F_1: RT1206BRD075KL; RESC3116X65N
R_10K_F_1: AC0805DR-0710KL; RESC2012X60N
R_C_1: AC0805JR-0712KL; RESC2012X60N
R_FAULT_1: AT0805FRE07100KL; RESC2012X60N
R_FB_1: AC0603FR-0764K9L; RESC1608X55N
R_GATE_1: AC0805FR-0710KL; RESC2012X60N
R_LED_10K_1: MCS0402MD1002DE000; RESC1005X37N
R_LS_DRAIN_1: MCS0402MD1002DE000; RESC1005X37N
R_LS_GATE_1: AT0805FRE07100KL; RESC2012X60N
R_SHUNT_GND_1: GMR100HTCFAR100; RESC6432X55N
R_T_1: AC0805FR-07124KL; RESC2012X60N
R_UVLO1_1: AC0805FR-0730KL; RESC2012X60N
R_UVLO2_1: RT1206BRD075KL; RESC3116X65N
TP_CF_1: S1751-46R; S1751-46R_
TP_CH_GND_1: S1751-46R; S1751-46R_
TP_CLK_1: S1751-46R; S1751-46R_
TP_CLK_F_1: S1751-46R; S1751-46R_
TP_D1_1: S1751-46R; S1751-46R_
TP_FAULT_1: S1751-46R; S1751-46R_
TP_FAULT_LS_1: S1751-46R; S1751-46R_
TP_FB_1: S1751-46R; S1751-46R_
TP_GATE_1: S1751-46R; S1751-46R_
TP_GND1_1, TP_GND2_1, TP_GND3_1, TP_GND4_1: S1751-46R; S1751-46R_
TP_GND_1: S1751-46R; S1751-46R_
TP_IN_1: S1751-46R; S1751-46R_
TP_OUT_1: S1751-46R; S1751-46R_
TP_RT_1: S1751-46R; S1751-46R_
TP_SHDN_1: S1751-46R; S1751-46R_
TP_SS_1: S1751-46R; S1751-46R_
TP_SW_1: S1751-46R; S1751-46R_

Connections:
CH_GND: R_SHUNT_GND_1.1, TP_CH_GND_1.1; also elsewhere on the board
CLK_1: LT3579_IC_1.16 (CLKOUT), R_10K_F_1.1, TP_CLK_1.1
CLK_FILTER_OUT_1: C_68N_F_1.1, R_5K_F_1.1, R_10K_F_1.2, TP_CLK_F_1.1; also elsewhere on the board
FAULT_1: LT3579_IC_1.4 (!FAULT), R_FAULT_1.1, R_LS_GATE_1.1, TP_FAULT_1.1
FAULT_LS_OUT_1: C_LS_1.1, NMOS_LDO_1.3 (D), R_LS_DRAIN_1.1, TP_FAULT_LS_1.1; also elsewhere on the board
FB_1: LT3579_IC_1.1 (FB), R_FB_1.2
GATE_1: LT3579_IC_1.3 (GATE), PMOS_1.1 (G), R_GATE_1.2, TP_GATE_1.1
GND: C_68N_F_1.2, C_C_1.2, C_F_1.2, C_IN_1_1.2, C_IN_2_1.2, C_LS_1.2, C_OUT_1_1.2, C_OUT_2_1.2, C_OUT_3_1.2, C_SS_1.2, L1L2_1.4, LED_1.2 (K), LT3579_IC_1.20 (SYNC), LT3579_IC_1.21 (EPAD), NMOS_LDO_1.2 (S), R_5K_F_1.2, R_SHUNT_GND_1.2, R_T_1.2, R_UVLO2_1.1, TP_GND1_1.1, TP_GND2_1.1, TP_GND3_1.1, TP_GND4_1.1, TP_GND_1.1; also elsewhere on the board
LDO_OUT_: R_LS_DRAIN_1.2; also elsewhere on the board
unnamed: C_1_1.2, D1_1.2 (A), L1L2_1.2, TP_D1_1.1
unnamed: C_C_1.1, R_C_1.2
unnamed: D1_1.1 (K), PMOS_1.3 (D), R_FB_1.1, R_GATE_1.1, TP_FB_1.1
unnamed: NMOS_LDO_1.1 (G), R_LS_GATE_1.2
unnamed: LED_1.1 (A), R_LED_10K_1.2
RT_1: LT3579_IC_1.18 (RT), R_T_1.1, TP_RT_1.1
SHDN_1: LT3579_IC_1.17 (!SHDN), R_UVLO1_1.1, R_UVLO2_1.2, TP_SHDN_1.1
SS_1: C_SS_1.1, LT3579_IC_1.19 (SS), TP_SS_1.1
SW1-2_1: C_1_1.1, L1L2_1.1, LT3579_IC_1.6 (SW1_1), LT3579_IC_1.7 (SW1_2), LT3579_IC_1.8 (SW1_3), LT3579_IC_1.9 (SW1_4), LT3579_IC_1.10 (SW1_5), LT3579_IC_1.11 (SW2_1), LT3579_IC_1.12 (SW2_2), LT3579_IC_1.13 (SW2_3), LT3579_IC_1.14 (SW2_4), LT3579_IC_1.15 (SW2_5), TP_SW_1.1
VC_1: C_F_1.1, LT3579_IC_1.2 (VC), R_C_1.1, TP_CF_1.1
VIN: C_IN_1_1.1, C_IN_2_1.1, L1L2_1.3, LT3579_IC_1.5 (VIN), R_FAULT_1.2, R_UVLO1_1.2, TP_IN_1.1; also elsewhere on the board
VOUT_1: C_OUT_1_1.1, C_OUT_2_1.1, C_OUT_3_1.1, PMOS_1.2 (S), R_LED_10K_1.1, TP_OUT_1.1; also elsewhere on the board

Notes on the sheet:
LT3579 SEPIC Config: 13Vin -> 6.5Vout
Ground Test Points
Filter to convert pulse signal to DC for MCU. Cutoff set at 700Hz. Gain = 1/3.
Logic Level Shifter. 13V to 3.3V for MCU.
Voltage divider by R_UVLO1/2 set the low voltage lockout for the LT3579. UVLO is set at 10V. LT3579 will turn off, if this min threshold is not met to protect battery.
R_C,C_C, and C_F form a recictor-capacitor network to compensate the voltage feedback loop in the LT3579.
Oscillator Timing Resistor (R_T) sets the operating freqeuncy of LT3579. Operating Frequency is set to 700KHz.
Soft-start: C_SS is in series w/ integrated 250K resistor of LT3579. Determins the charging and discharing rate when the part shutsdown.
GND test points to be placed near signal and pwr test points.
Pull up resistor for the FAULT indicator pin. FAULT can be pulled low externally or internally.
PWR on light indicator.
Output Capacitors to reduce voltage ripple
Feedback Resistor (R_B) sets the output voltage of the circuit.
PMOS for output disconnect. GATE pin turns off or on the PMOS.
Input Capacitors to reduce ripple voltage from battery.
Input
Shunt resistor to measure the difference between chasis GND and signal GND.

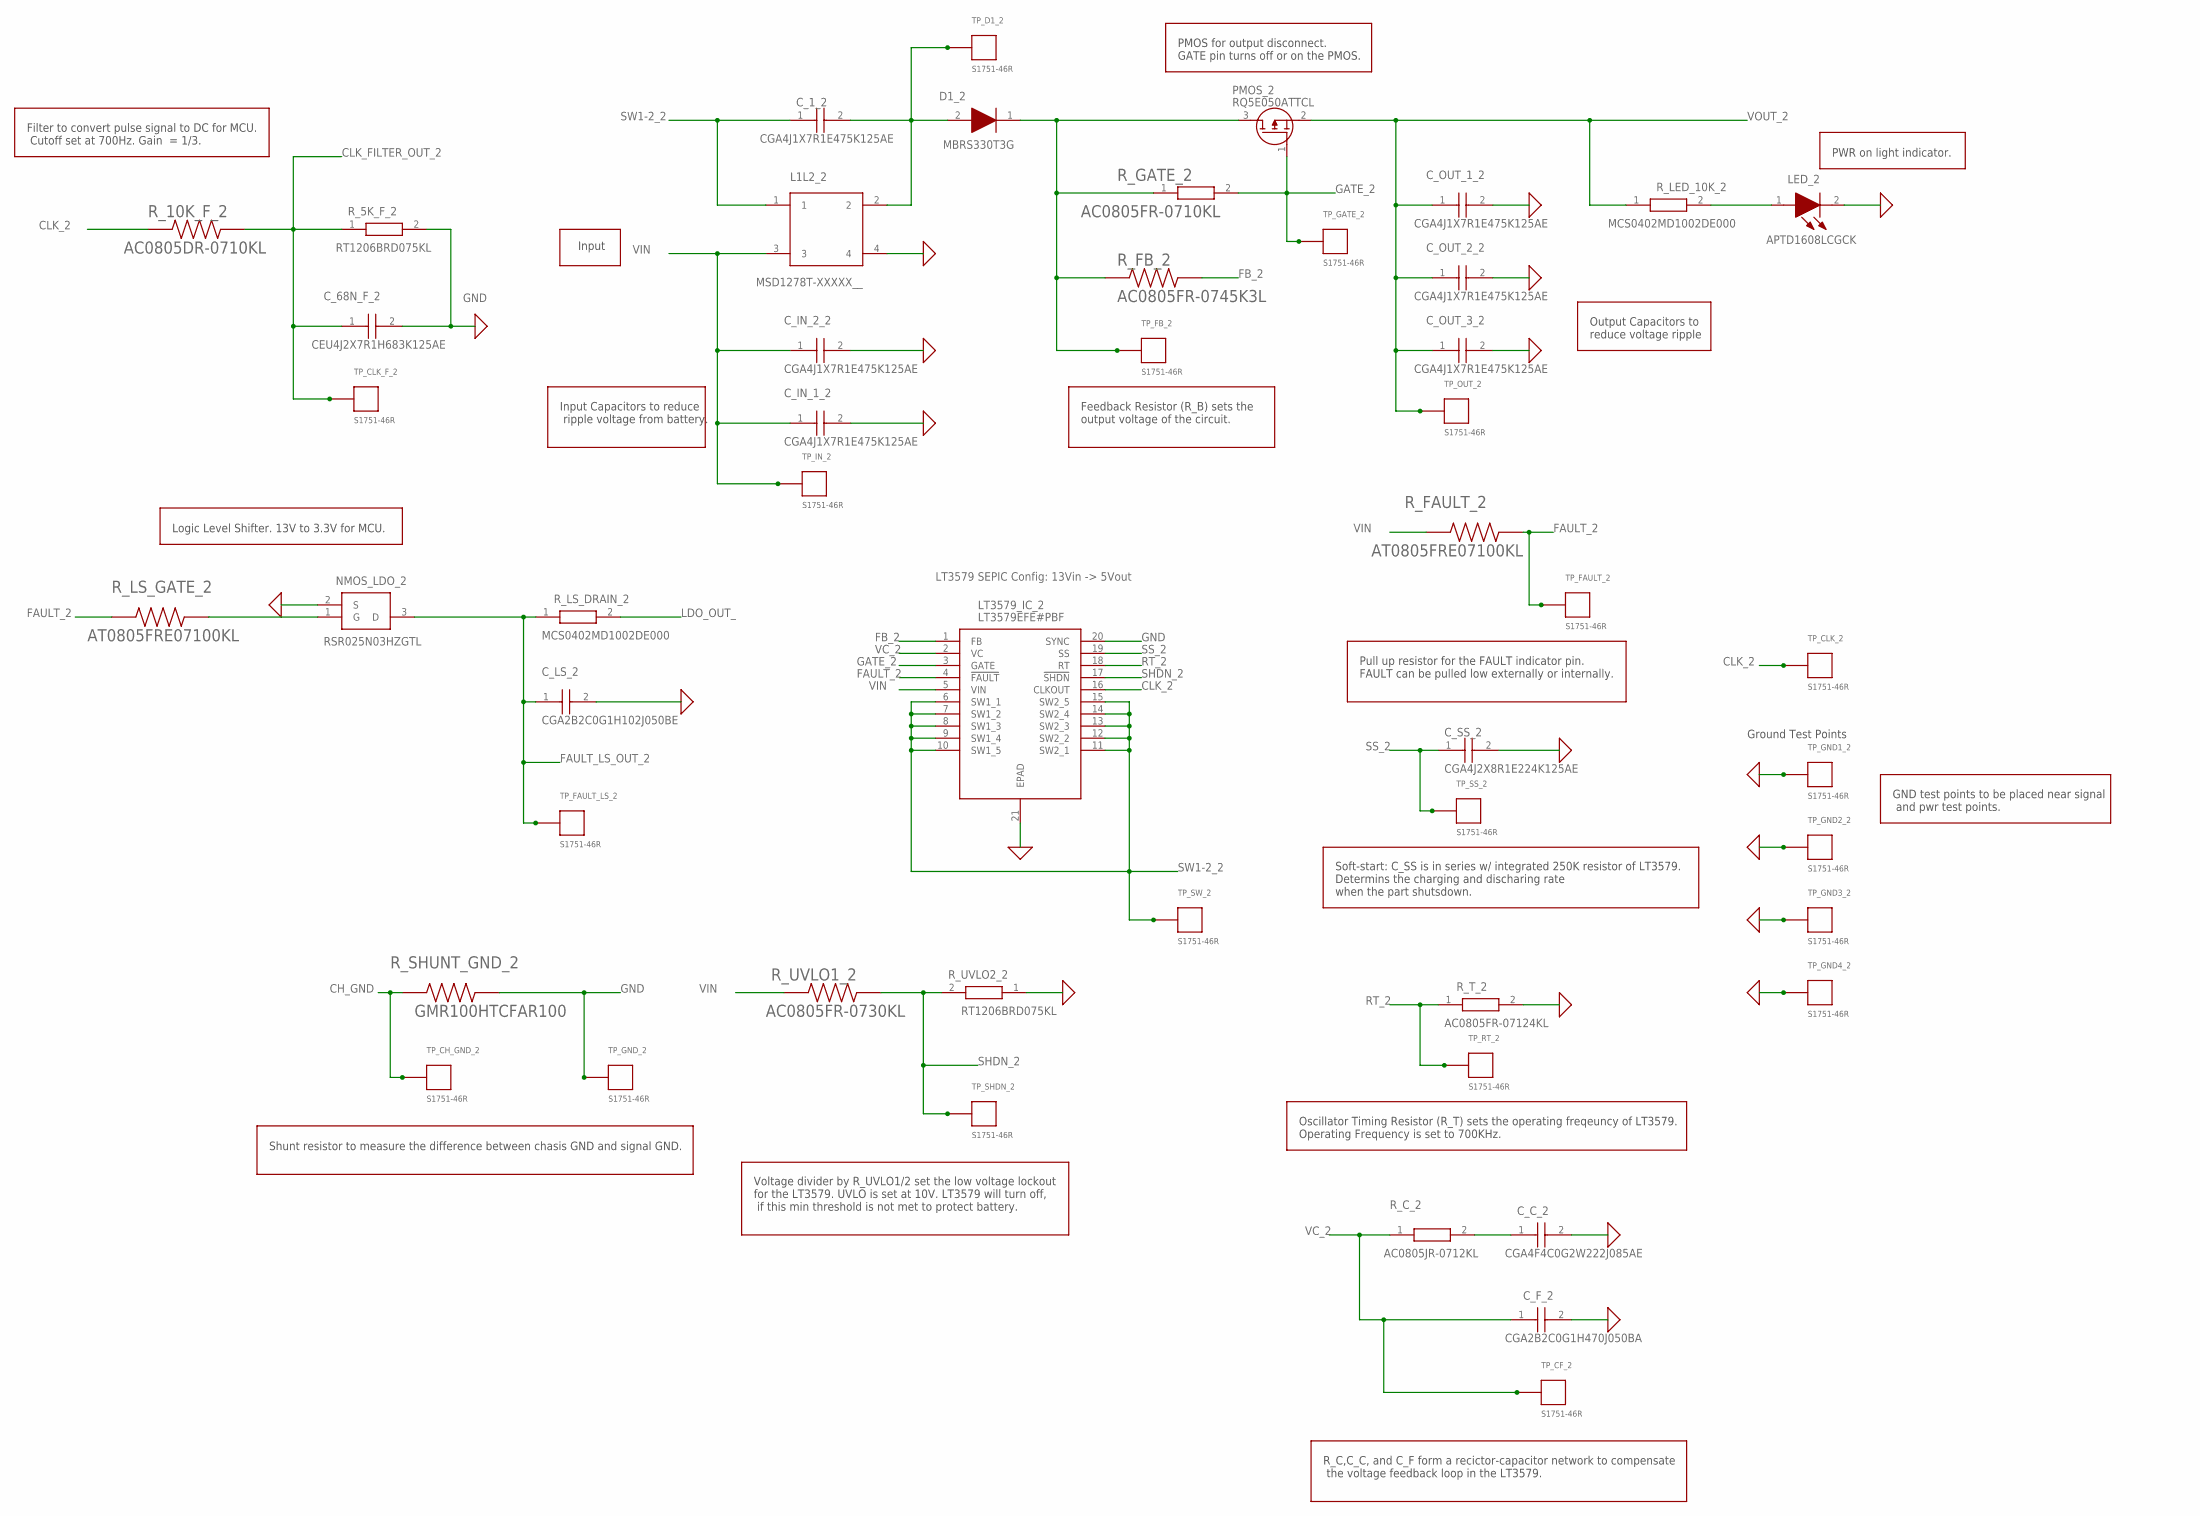
[picture p9: schematic LT3579_SEPIC_Test_Bench.sch, sheet 4]

Parts:
C_1_2: CGA4J1X7R1E475K125AE; CAPC2012X145N
C_68N_F_2: CEU4J2X7R1H683K125AE; CAPC2013X150N
C_C_2: CGA4F4C0G2W222J085AE; CAPC2012X100N
C_F_2: CGA2B2C0G1H470J050BA; CAPC1005X55N
C_IN_1_2, C_IN_2_2: CGA4J1X7R1E475K125AE; CAPC2012X145N
C_LS_2: CGA2B2C0G1H102J050BE; CAPC1005X55N
C_OUT_1_2, C_OUT_2_2, C_OUT_3_2: CGA4J1X7R1E475K125AE; CAPC2012X145N
C_SS_2: CGA4J2X8R1E224K125AE; CAPC2012X145N
D1_2: MBRS330T3G; DIOM7958X256N
L1L2_2: MSD1278T-XXXXX__; MSD1278T-822MLXX
LED_2: APTD1608LCGCK; APT1608CGCK
LT3579_IC_2: LT3579EFE#PBF; SOP65P640X120-21N
NMOS_LDO_2: RSR025N03HZGTL; SOT95P280X100-3N
PMOS_2: RQ5E050ATTCL; SOT95P280X100-3N
R_5K_F_2: RT1206BRD075KL; RESC3116X65N
R_10K_F_2: AC0805DR-0710KL; RESC2012X60N
R_C_2: AC0805JR-0712KL; RESC2012X60N
R_FAULT_2: AT0805FRE07100KL; RESC2012X60N
R_FB_2: AC0805FR-0745K3L; RESC2012X60N
R_GATE_2: AC0805FR-0710KL; RESC2012X60N
R_LED_10K_2: MCS0402MD1002DE000; RESC1005X37N
R_LS_DRAIN_2: MCS0402MD1002DE000; RESC1005X37N
R_LS_GATE_2: AT0805FRE07100KL; RESC2012X60N
R_SHUNT_GND_2: GMR100HTCFAR100; RESC6432X55N
R_T_2: AC0805FR-07124KL; RESC2012X60N
R_UVLO1_2: AC0805FR-0730KL; RESC2012X60N
R_UVLO2_2: RT1206BRD075KL; RESC3116X65N
TP_CF_2: S1751-46R; S1751-46R_
TP_CH_GND_2: S1751-46R; S1751-46R_
TP_CLK_2: S1751-46R; S1751-46R_
TP_CLK_F_2: S1751-46R; S1751-46R_
TP_D1_2: S1751-46R; S1751-46R_
TP_FAULT_2: S1751-46R; S1751-46R_
TP_FAULT_LS_2: S1751-46R; S1751-46R_
TP_FB_2: S1751-46R; S1751-46R_
TP_GATE_2: S1751-46R; S1751-46R_
TP_GND1_2, TP_GND2_2, TP_GND3_2, TP_GND4_2: S1751-46R; S1751-46R_
TP_GND_2: S1751-46R; S1751-46R_
TP_IN_2: S1751-46R; S1751-46R_
TP_OUT_2: S1751-46R; S1751-46R_
TP_RT_2: S1751-46R; S1751-46R_
TP_SHDN_2: S1751-46R; S1751-46R_
TP_SS_2: S1751-46R; S1751-46R_
TP_SW_2: S1751-46R; S1751-46R_

Connections:
CH_GND: R_SHUNT_GND_2.1, TP_CH_GND_2.1; also elsewhere on the board
CLK_2: LT3579_IC_2.16 (CLKOUT), R_10K_F_2.1, TP_CLK_2.1
CLK_FILTER_OUT_2: C_68N_F_2.1, R_5K_F_2.1, R_10K_F_2.2, TP_CLK_F_2.1; also elsewhere on the board
FAULT_2: LT3579_IC_2.4 (!FAULT), R_FAULT_2.1, R_LS_GATE_2.1, TP_FAULT_2.1
FAULT_LS_OUT_2: C_LS_2.1, NMOS_LDO_2.3 (D), R_LS_DRAIN_2.1, TP_FAULT_LS_2.1; also elsewhere on the board
FB_2: LT3579_IC_2.1 (FB), R_FB_2.2
GATE_2: LT3579_IC_2.3 (GATE), PMOS_2.1 (G), R_GATE_2.2, TP_GATE_2.1
GND: C_68N_F_2.2, C_C_2.2, C_F_2.2, C_IN_1_2.2, C_IN_2_2.2, C_LS_2.2, C_OUT_1_2.2, C_OUT_2_2.2, C_OUT_3_2.2, C_SS_2.2, L1L2_2.4, LED_2.2 (K), LT3579_IC_2.20 (SYNC), LT3579_IC_2.21 (EPAD), NMOS_LDO_2.2 (S), R_5K_F_2.2, R_SHUNT_GND_2.2, R_T_2.2, R_UVLO2_2.1, TP_GND1_2.1, TP_GND2_2.1, TP_GND3_2.1, TP_GND4_2.1, TP_GND_2.1; also elsewhere on the board
LDO_OUT_: R_LS_DRAIN_2.2; also elsewhere on the board
unnamed: C_1_2.2, D1_2.2 (A), L1L2_2.2, TP_D1_2.1
unnamed: C_C_2.1, R_C_2.2
unnamed: D1_2.1 (K), PMOS_2.3 (D), R_FB_2.1, R_GATE_2.1, TP_FB_2.1
unnamed: NMOS_LDO_2.1 (G), R_LS_GATE_2.2
unnamed: LED_2.1 (A), R_LED_10K_2.2
RT_2: LT3579_IC_2.18 (RT), R_T_2.1, TP_RT_2.1
SHDN_2: LT3579_IC_2.17 (!SHDN), R_UVLO1_2.1, R_UVLO2_2.2, TP_SHDN_2.1
SS_2: C_SS_2.1, LT3579_IC_2.19 (SS), TP_SS_2.1
SW1-2_2: C_1_2.1, L1L2_2.1, LT3579_IC_2.6 (SW1_1), LT3579_IC_2.7 (SW1_2), LT3579_IC_2.8 (SW1_3), LT3579_IC_2.9 (SW1_4), LT3579_IC_2.10 (SW1_5), LT3579_IC_2.11 (SW2_1), LT3579_IC_2.12 (SW2_2), LT3579_IC_2.13 (SW2_3), LT3579_IC_2.14 (SW2_4), LT3579_IC_2.15 (SW2_5), TP_SW_2.1
VC_2: C_F_2.1, LT3579_IC_2.2 (VC), R_C_2.1, TP_CF_2.1
VIN: C_IN_1_2.1, C_IN_2_2.1, L1L2_2.3, LT3579_IC_2.5 (VIN), R_FAULT_2.2, R_UVLO1_2.2, TP_IN_2.1; also elsewhere on the board
VOUT_2: C_OUT_1_2.1, C_OUT_2_2.1, C_OUT_3_2.1, PMOS_2.2 (S), R_LED_10K_2.1, TP_OUT_2.1; also elsewhere on the board

Notes on the sheet:
LT3579 SEPIC Config: 13Vin -> 5Vout
Ground Test Points
Filter to convert pulse signal to DC for MCU. Cutoff set at 700Hz. Gain = 1/3.
Logic Level Shifter. 13V to 3.3V for MCU.
Voltage divider by R_UVLO1/2 set the low voltage lockout for the LT3579. UVLO is set at 10V. LT3579 will turn off, if this min threshold is not met to protect battery.
R_C,C_C, and C_F form a recictor-capacitor network to compensate the voltage feedback loop in the LT3579.
Oscillator Timing Resistor (R_T) sets the operating freqeuncy of LT3579. Operating Frequency is set to 700KHz.
Soft-start: C_SS is in series w/ integrated 250K resistor of LT3579. Determins the charging and discharing rate when the part shutsdown.
GND test points to be placed near signal and pwr test points.
Pull up resistor for the FAULT indicator pin. FAULT can be pulled low externally or internally.
PWR on light indicator.
Output Capacitors to reduce voltage ripple
Feedback Resistor (R_B) sets the output voltage of the circuit.
PMOS for output disconnect. GATE pin turns off or on the PMOS.
Input Capacitors to reduce ripple voltage from battery.
Input
Shunt resistor to measure the difference between chasis GND and signal GND.
