JovanyZepeda/Baja-CPP-Power-Module/LT3579-SEPIC-EAGLE-Project/LT3579_SEPIC_Test_Bench.brd

## EAGLE design LT3579-SEPIC-EAGLE-Project/LT3579_SEPIC_Test_Bench.brd (continued)

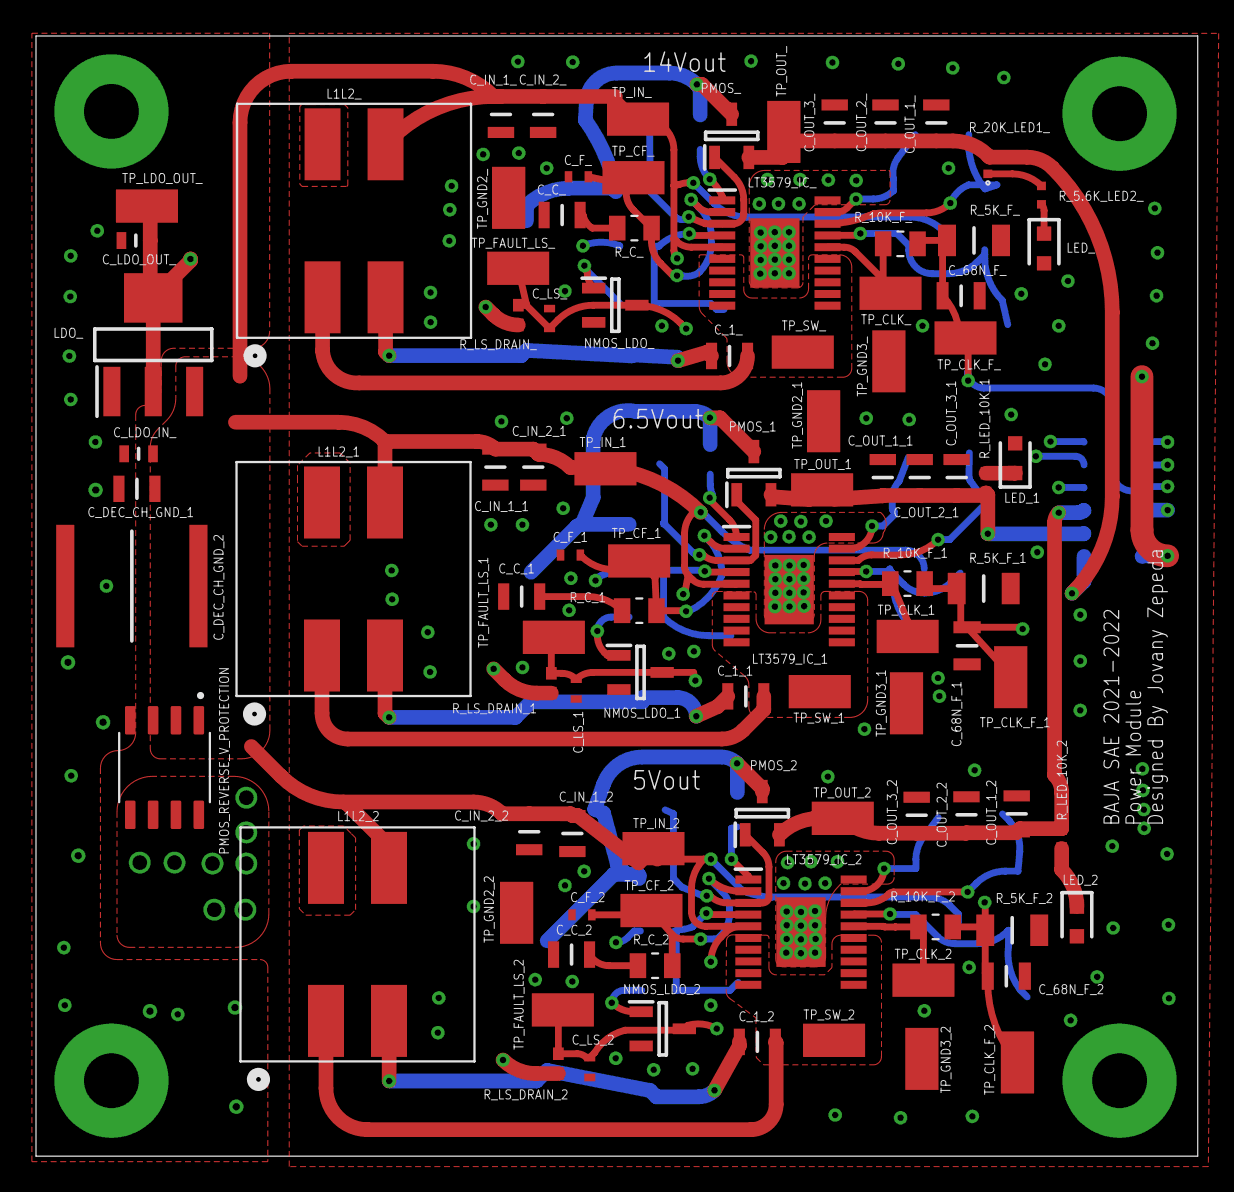
[picture p10: board LT3579_SEPIC_Test_Bench.brd from above]

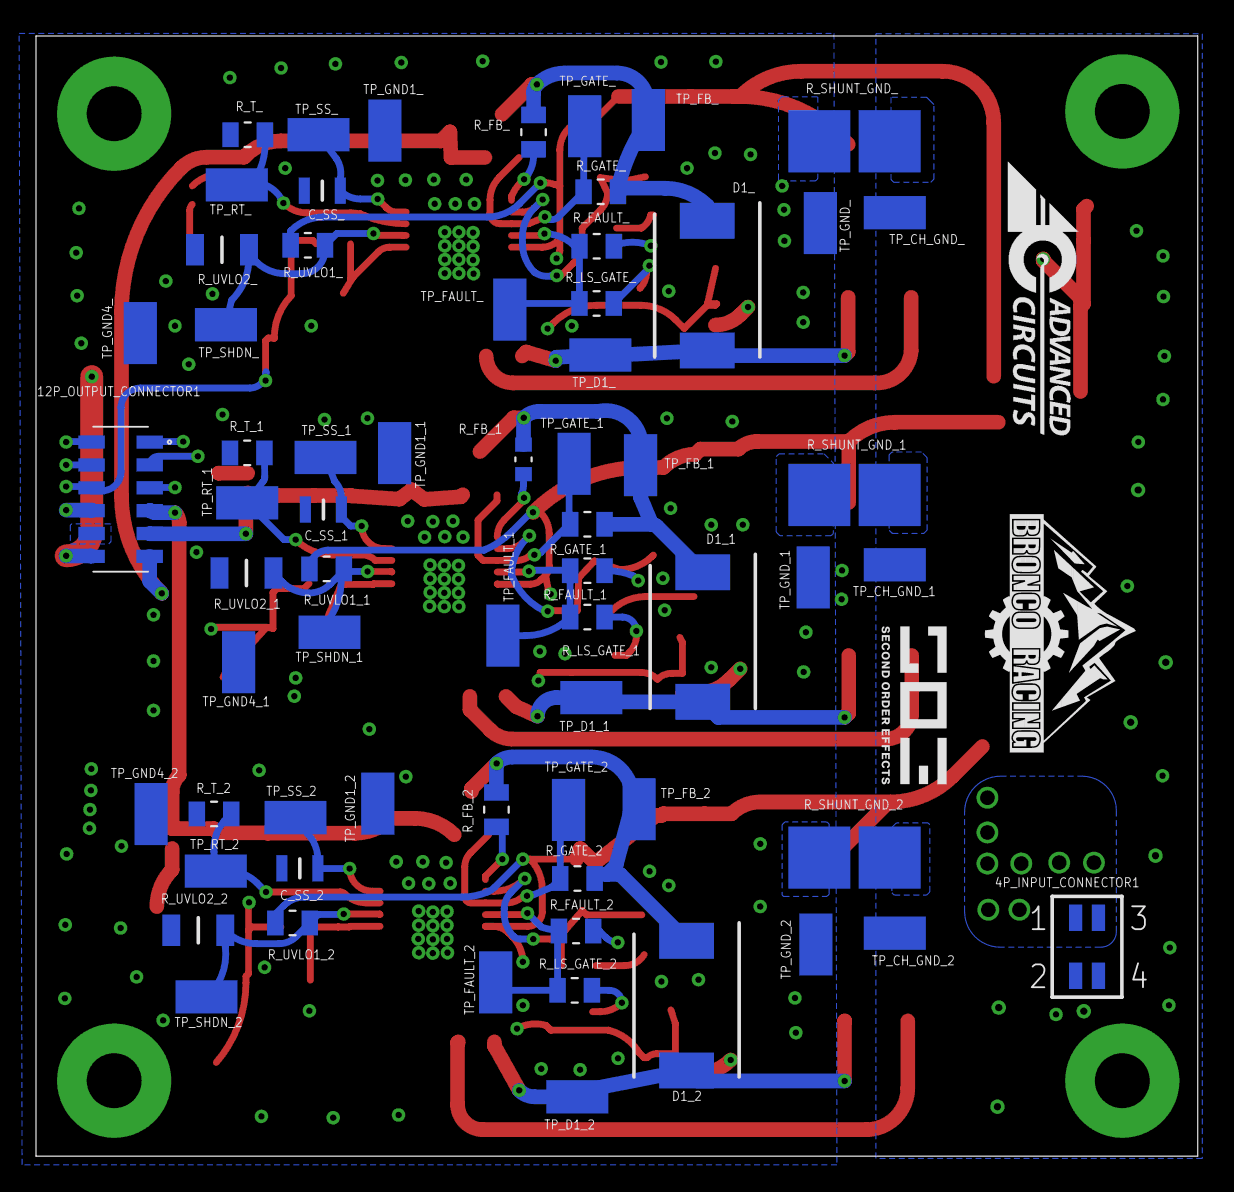
[picture p11: board LT3579_SEPIC_Test_Bench.brd from below]

Board: 4 copper layers, 64.5 x 62.2 mm, 164 parts (65 on the bottom side), 57 nets.
