JovanyZepeda/Baja-CPP-Power-Module/(commit log)

2022-02-13 Testing and playing around with simulation. High Current Spikes still present
2022-02-14 Discover new diode MBRS360 works better. Continue ahead in choosing parts.
2022-02-19 Made new files for short circuit and undervoltage lockout testing
2022-02-25 made new schematic for input inductance
2022-02-25 Added new files for simulating wire inductance
2022-02-26 Updated circuit
2022-03-05 added undervoltage and short circuit test for vout 6.5 and 5vout
2022-03-06 started PCB design
    [LT3579_SEPIC_Test_Bench.sch]
2022-03-17 Modfied EAGLE schematic
2022-03-17 Modified Schematic EAGLE
    [LT3579_SEPIC_Test_Bench.sch]
2022-03-18 Added Custom Libraries
    [SDT5H100SB-13.stl, SDT5H100SB-13.stp]
2022-03-18 Added New Libraries and modified schematic
    [LT3579_SEPIC_Test_Bench.sch, SDT5H100SB-13.stl, SDT5H100SB-13.stp]
2022-03-19 Modfied Schematics
2022-03-19 Modified Eagle Project and Schematic
    [LT3579_SEPIC_Test_Bench.sch]
2022-03-19 Modfied Schematic files eagle
    [LT3579_SEPIC_Test_Bench.sch]
2022-03-20 Added Board Layout. Initial Board Layout done.
    [LT3579_SEPIC_Test_Bench.brd, LT3579_SEPIC_Test_Bench.sch]
2022-03-21 new files
    [LT3579_SEPIC_Test_Bench.brd, LT3579_SEPIC_Test_Bench.sch]
2022-03-29 Removed and replaced files
    [LT3579_SEPIC_Test_Bench.brd, LT3579_SEPIC_Test_Bench.sch]
2022-04-07 Added and Replaced new files
    [LT3579_SEPIC_Test_Bench.brd, LT3579_SEPIC_Test_Bench.sch]
2022-04-09 Added new FIles
    [LT3579_SEPIC_Test_Bench.brd, LT3579_SEPIC_Test_Bench.sch]
2022-04-27 LAPTOP: Updated files from other repo and copied them here.
    [LT3579_SEPIC_Test_Bench.brd, LT3579_SEPIC_Test_Bench.sch]
